zaku0101/mgr_board/hw/documents/mgr_board__Assembly.pdf

1 | 2 | 3 | 4 | 5 | 6

A

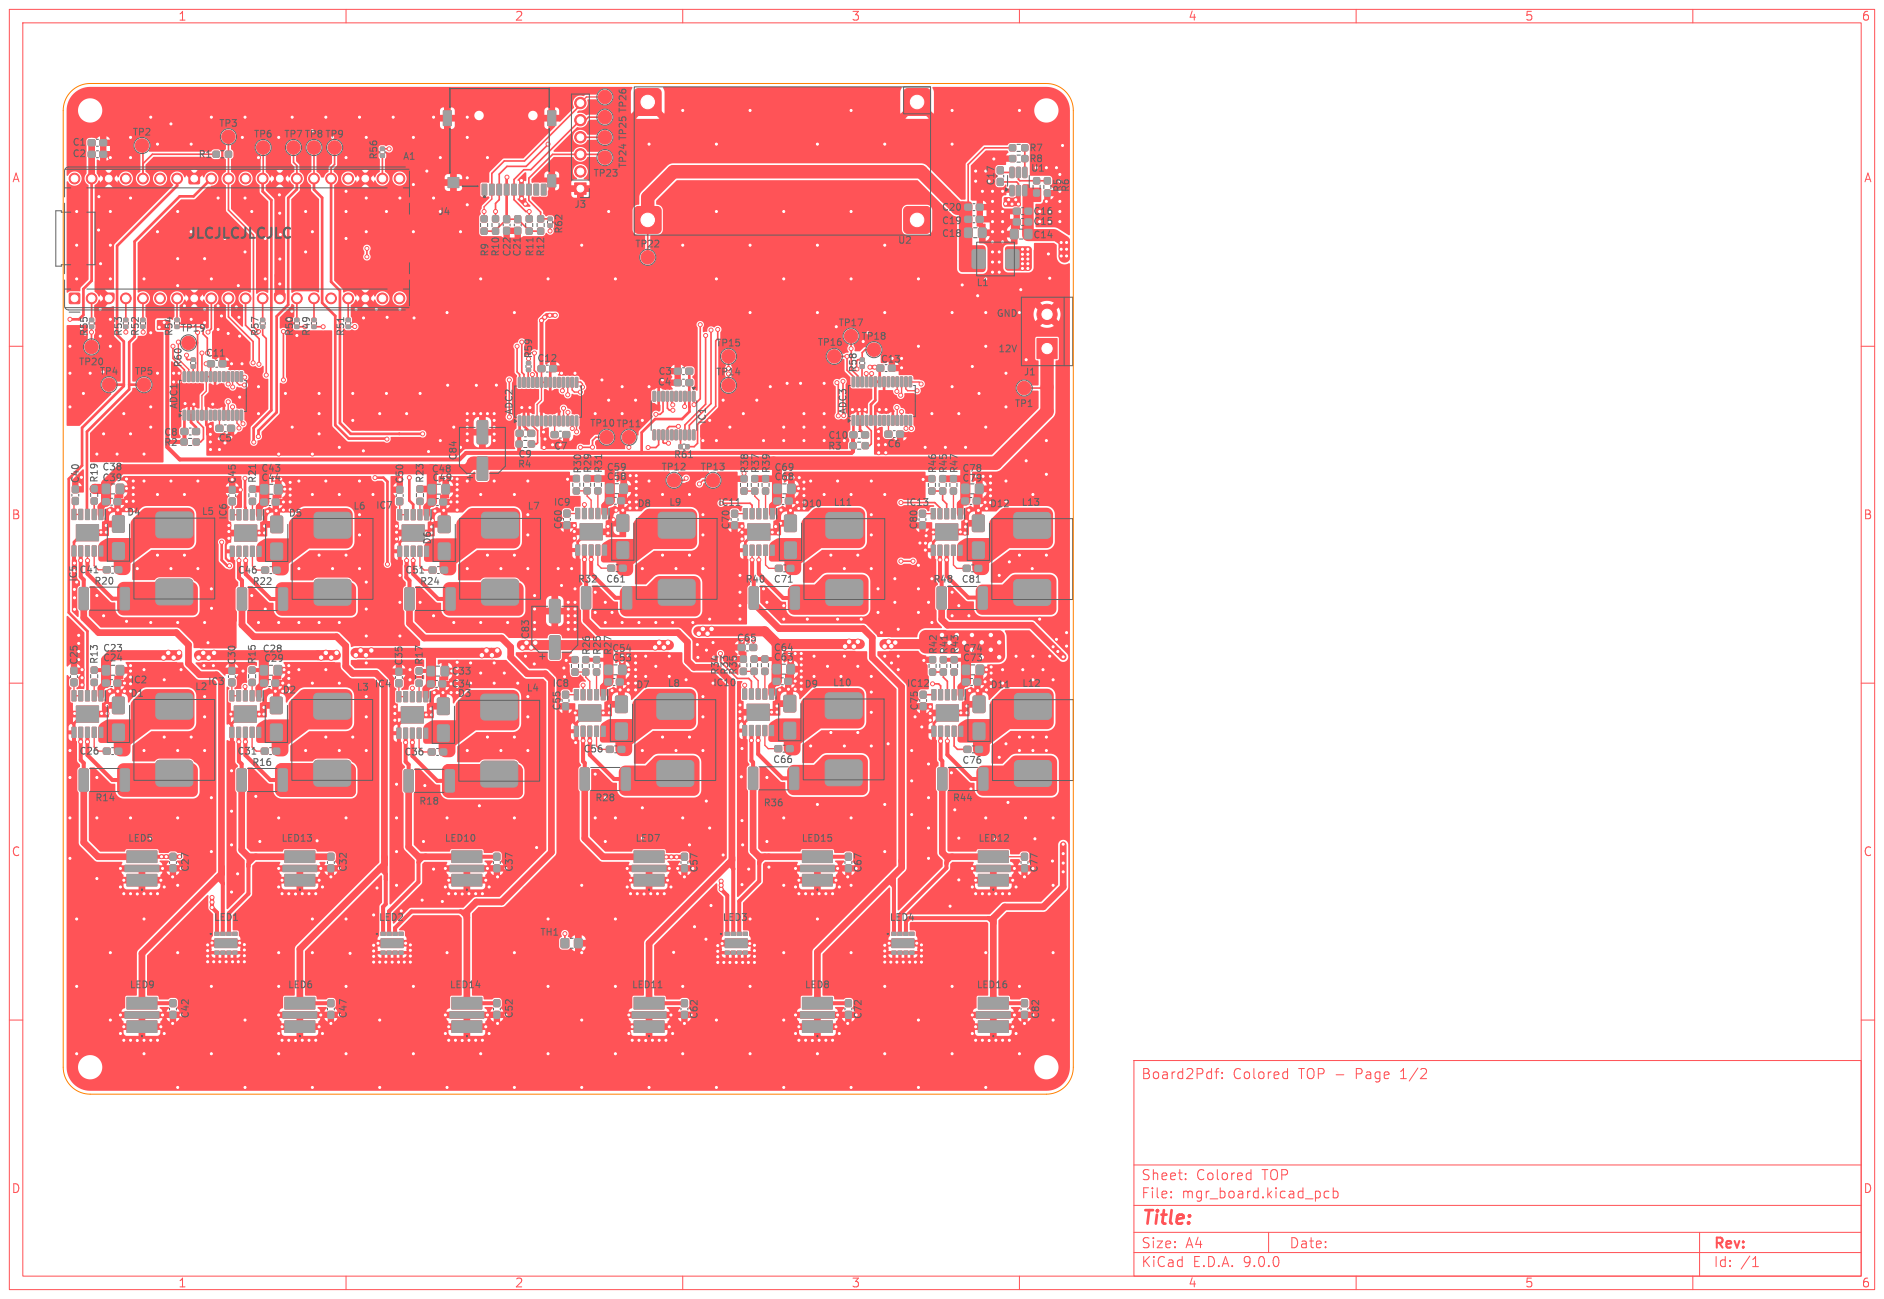
[picture p1: page 1]

1 | 2 | 3 | 4 | 5 | 6

A

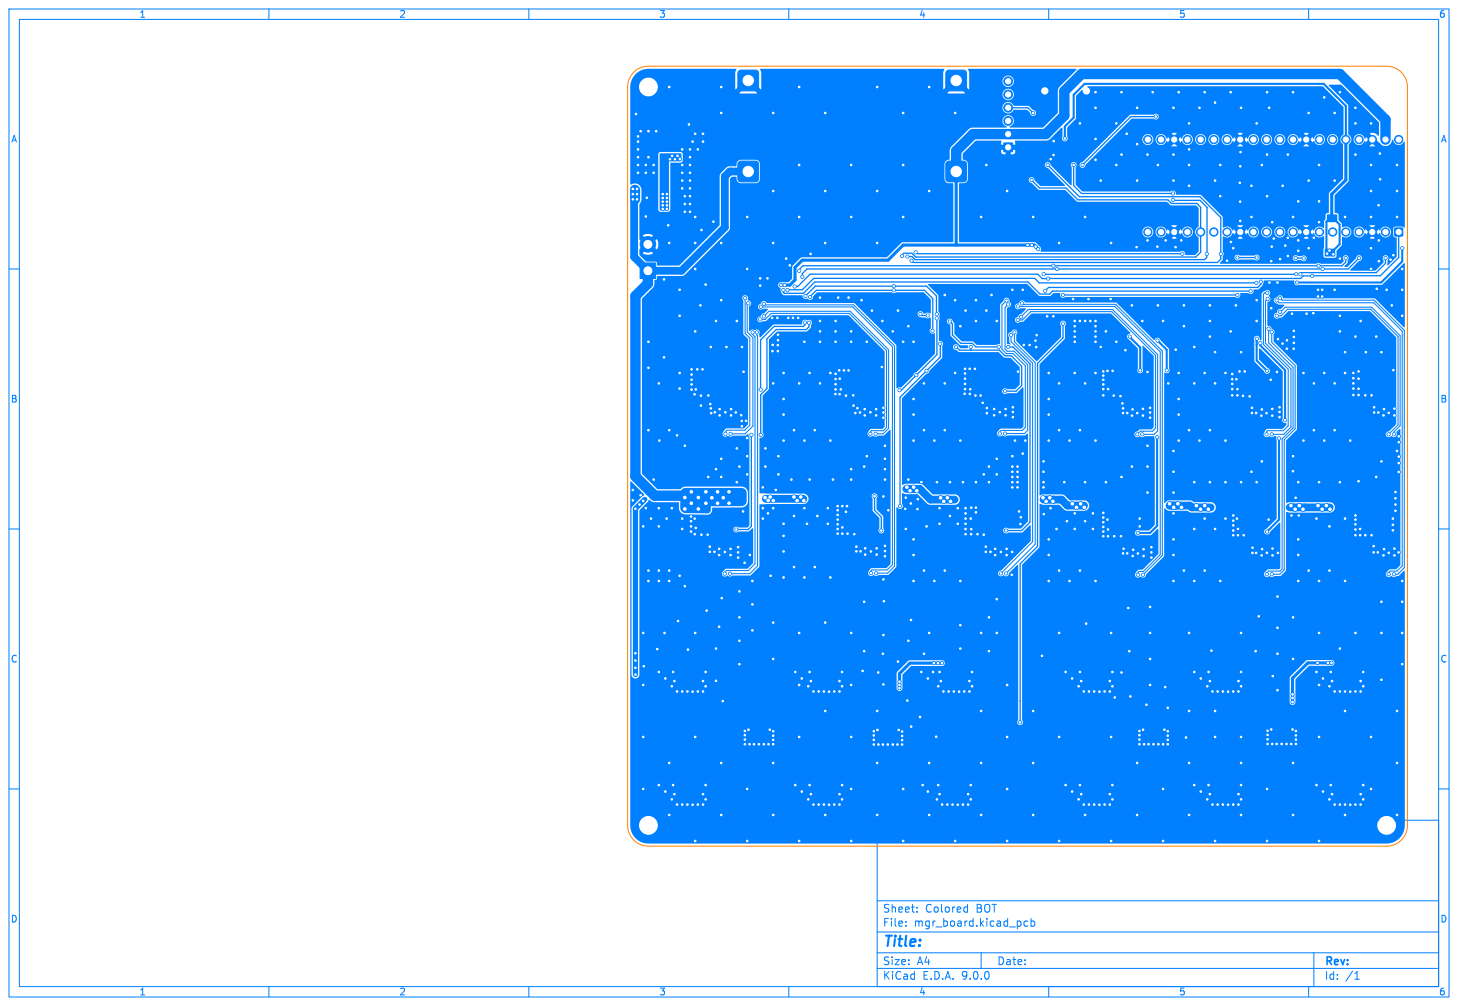
[picture p2: page 2]
D Date: KiCad; E.D.A. 9.0.0 Size: A4; Rev:; Id: /1 Title: File: mgr_board.kicad_pcb Sheet: Colored; BOT Board2Pdf:; Colored; BOT -; Page 2/2
