zaku0101/mgr_board/hw/documents/mgr_board.pdf

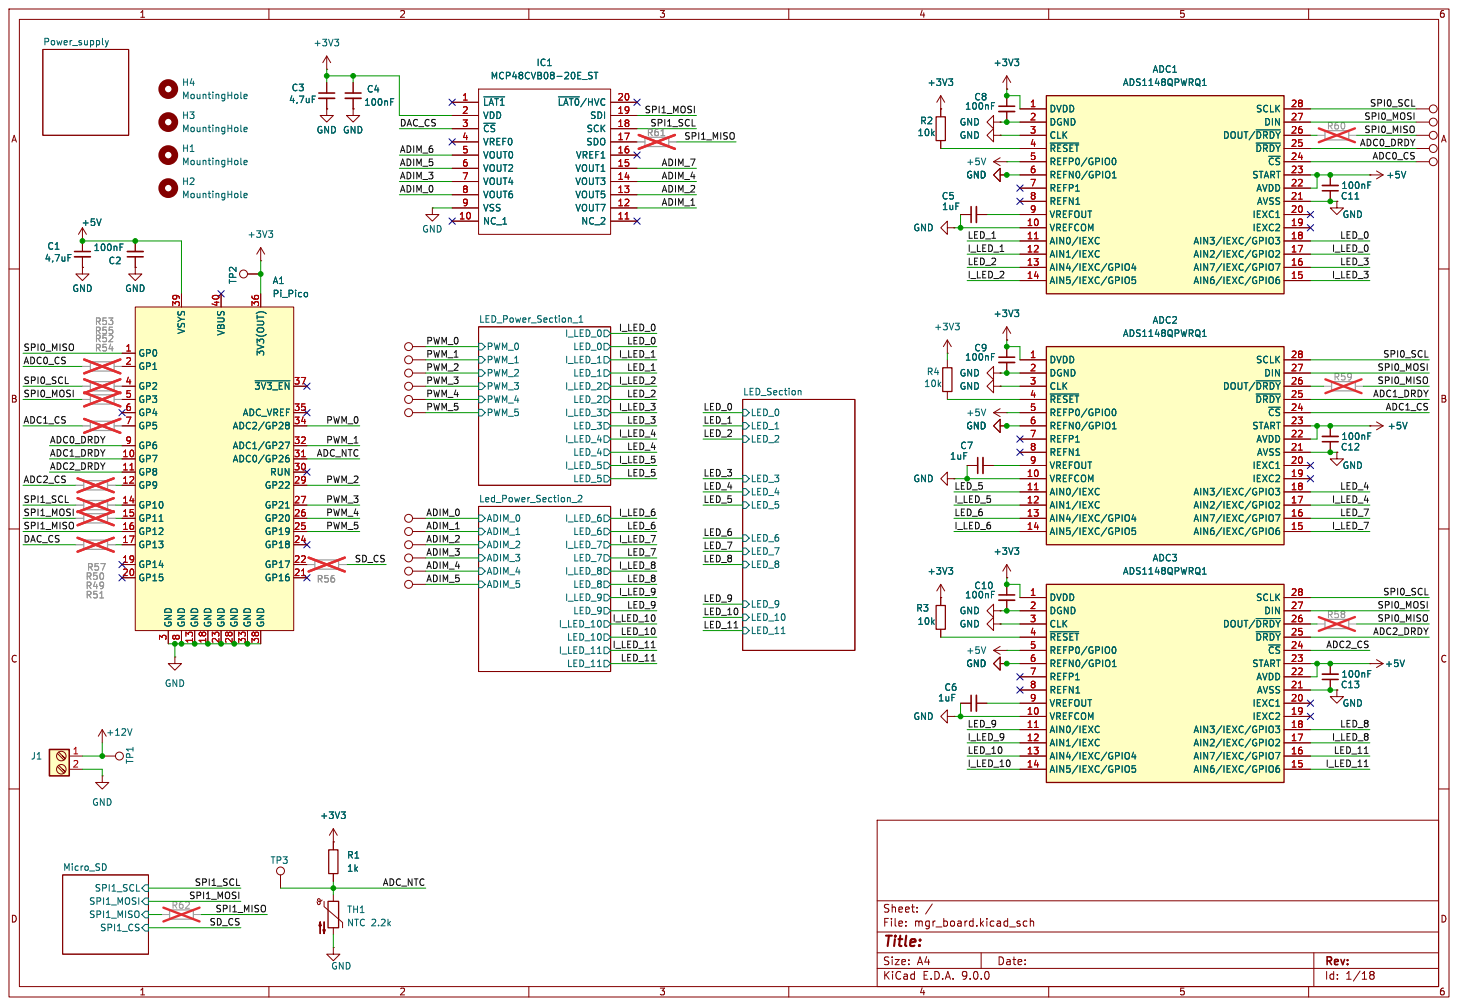
[picture p3: page 1]

8 GND 13 GND 18 VBUS 40 GND 23 GND 28 GND 33 3V3(OUT) 36 GND 38

SPI1_MOSI SPI1_MISO
Id: 1/18 Title: File: mgr_board.kicad_sch Sheet: / SPI1_CS

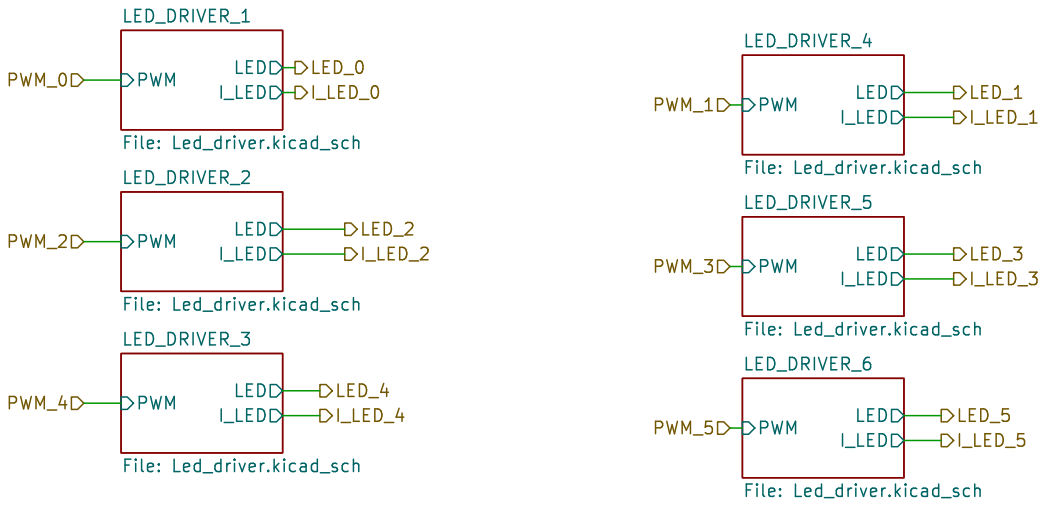
[picture p4: page 2]

Id: 2/18 Title: File: LED_Power_Section_1.kicad_sch Sheet: /LED_Power_Section_1/

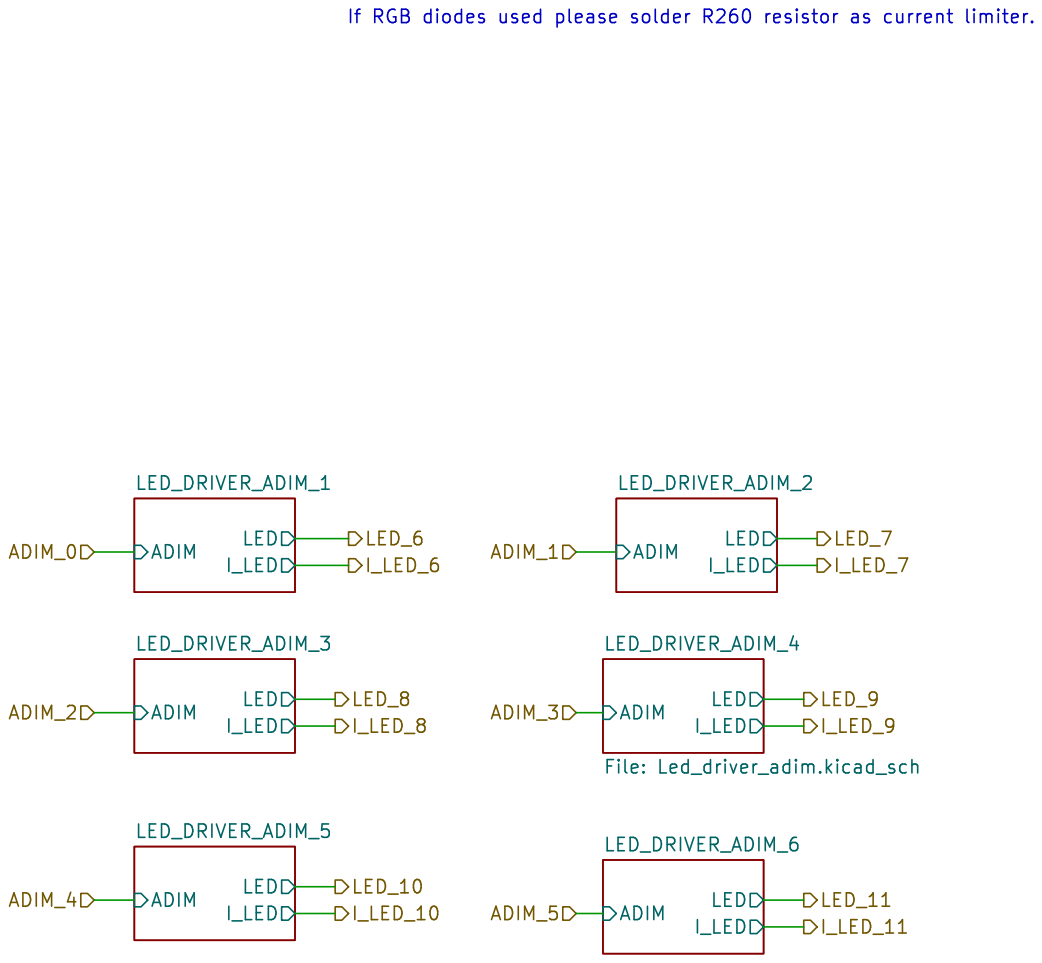
[picture p5: page 3]

Id: 3/18 Title: File: Led_Power_Section_2.kicad_sch Sheet: /Led_Power_Section_2/

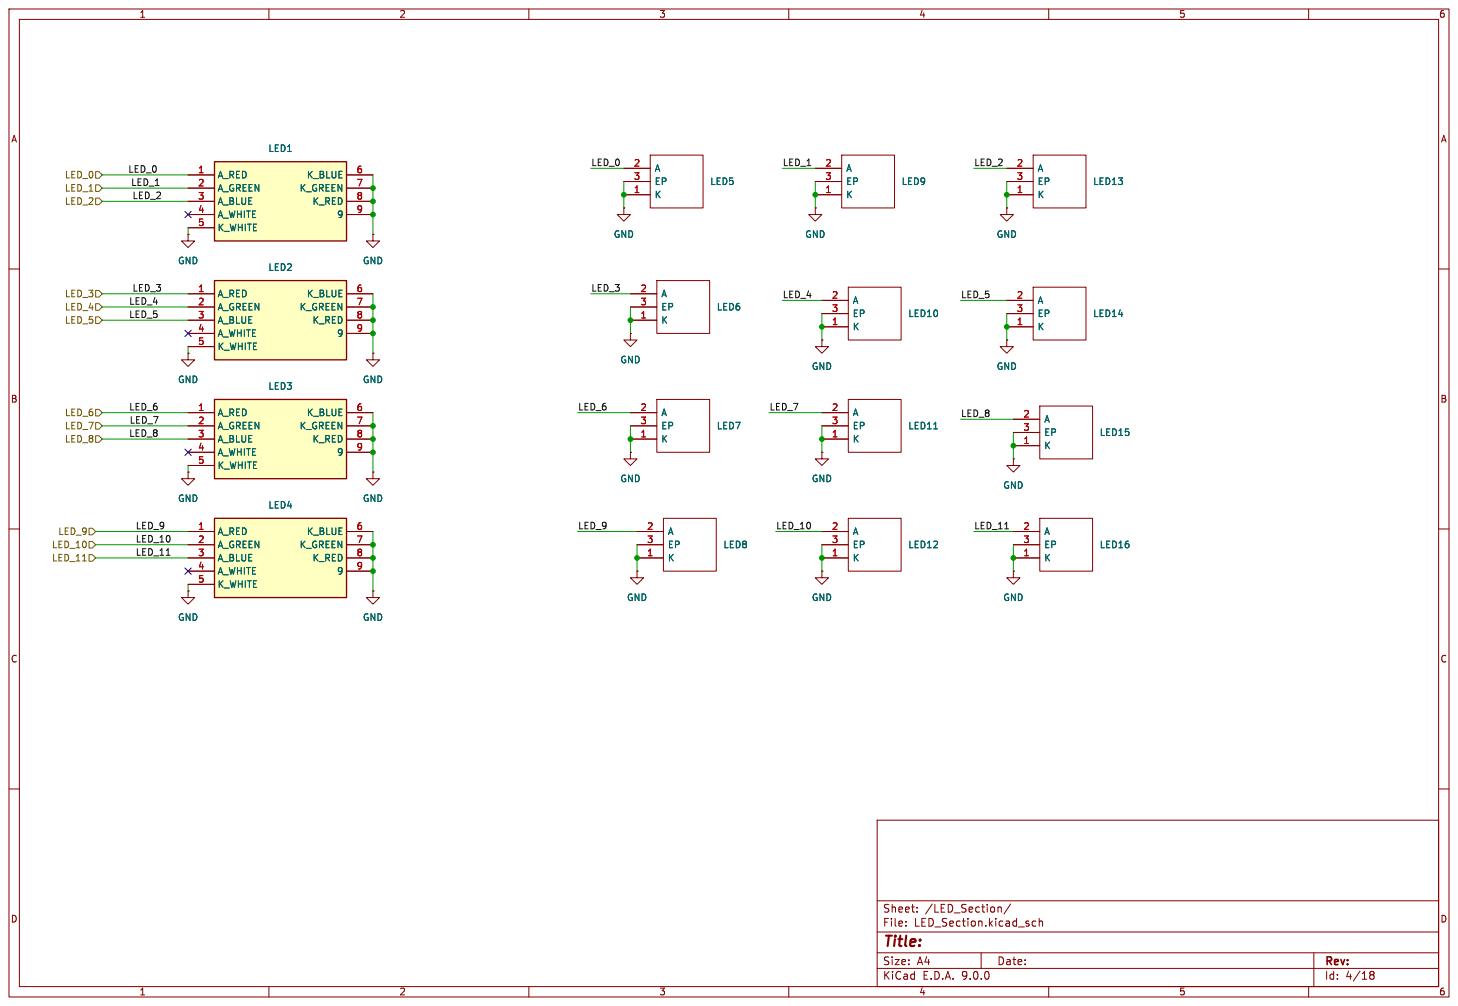
[picture p6: page 4]

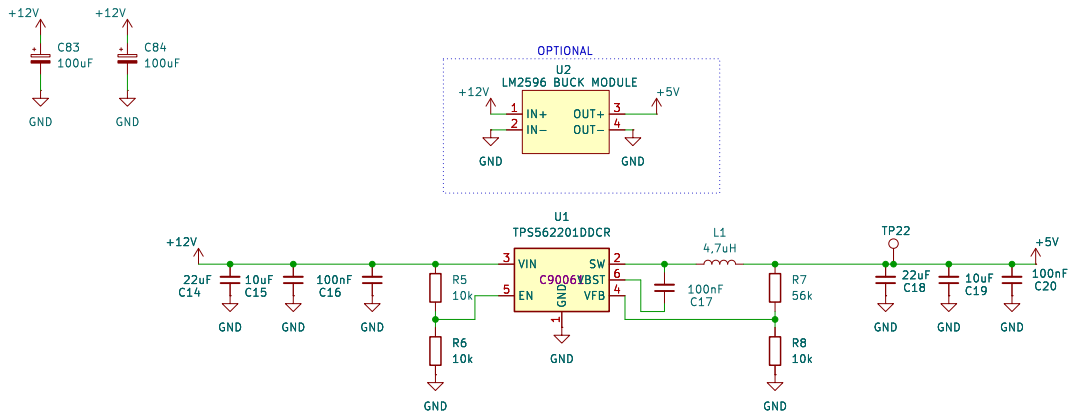
[picture p7: page 5]

Id: 5/18 Title: File: Power_supply.kicad_sch Sheet: /Power_supply/

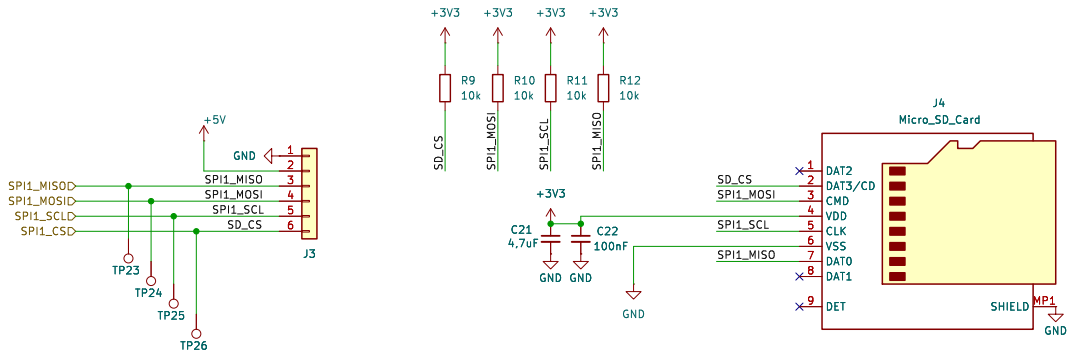
[picture p8: page 6]

Id: 6/18 Title: File: Micro_SD.kicad_sch Sheet: /Micro_SD/

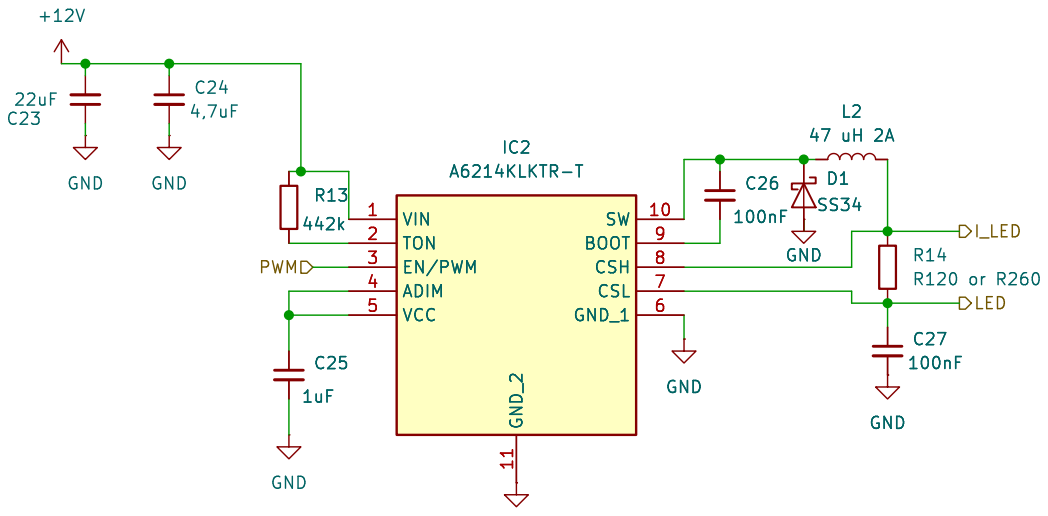
[picture p9: page 7]

Id: 7/18 Title: File: Led_driver.kicad_sch Sheet: /LED_Power_Section_1/LED_DRIVER_1/ C25

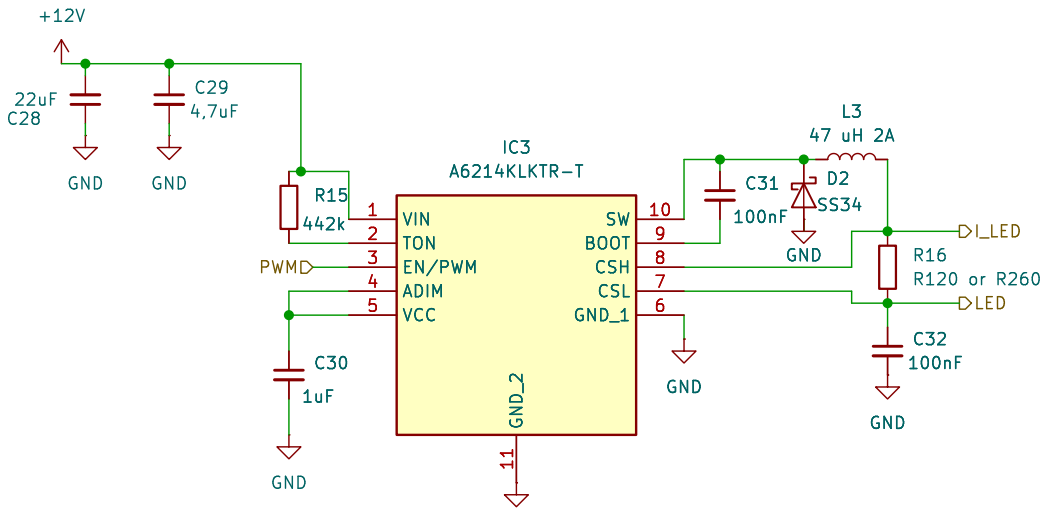
[picture p10: page 8]

Id: 8/18 Title: File: Led_driver.kicad_sch Sheet: /LED_Power_Section_1/LED_DRIVER_2/ C30

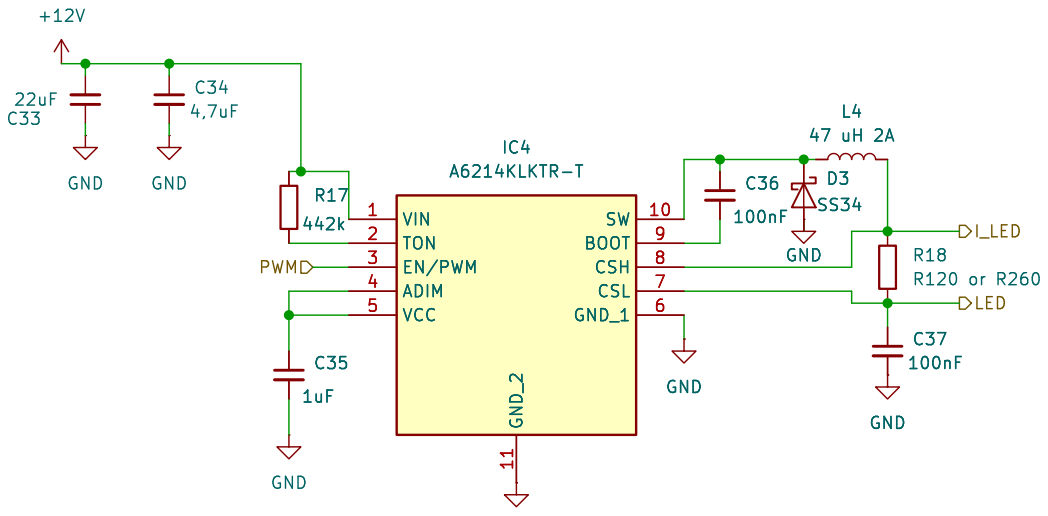
[picture p11: page 9]

Id: 9/18 Title: File: Led_driver.kicad_sch Sheet: /LED_Power_Section_1/LED_DRIVER_3/ C35

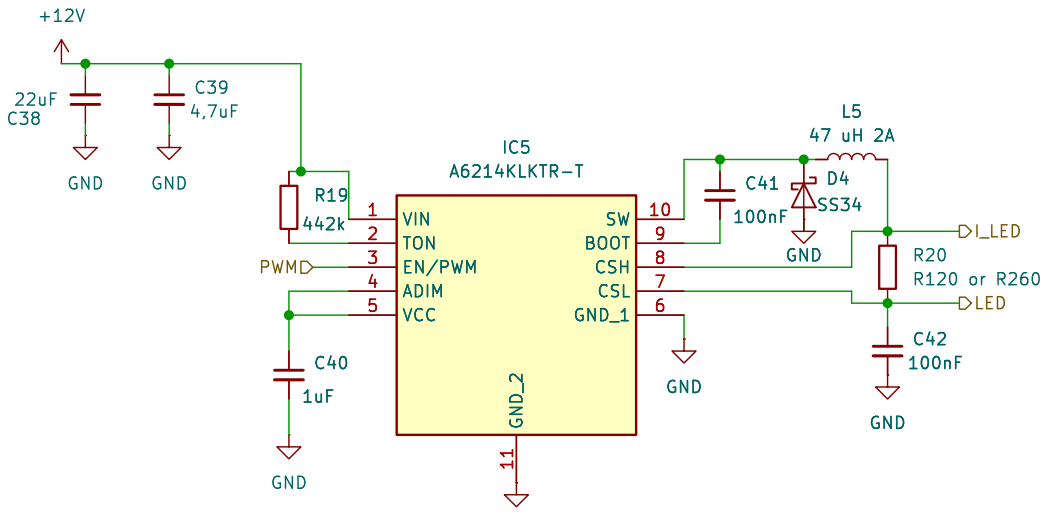
[picture p12: page 10]

Id: 10/18 Title: File: Led_driver.kicad_sch Sheet: /LED_Power_Section_1/LED_DRIVER_4/ C40

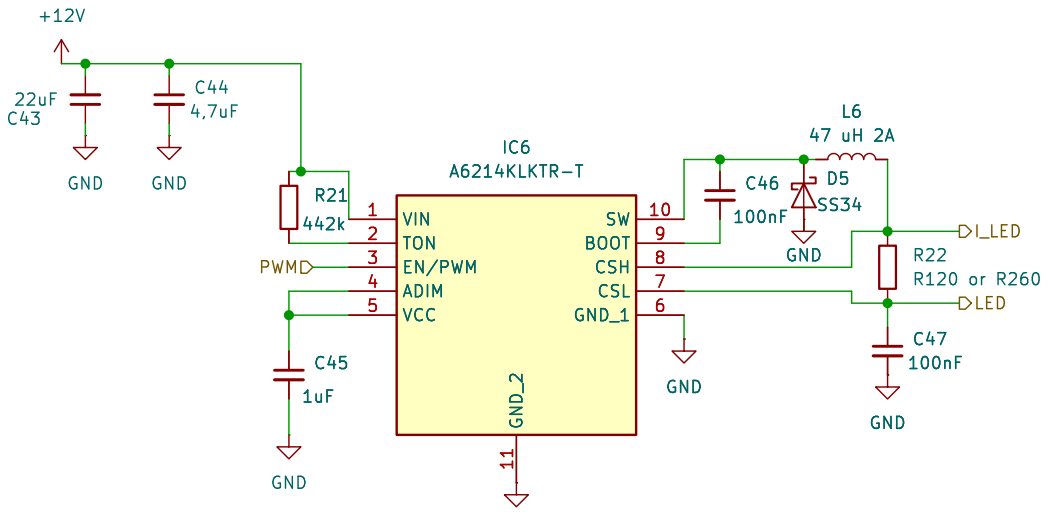
[picture p13: page 11]

Id: 11/18 Title: File: Led_driver.kicad_sch Sheet: /LED_Power_Section_1/LED_DRIVER_5/ C45

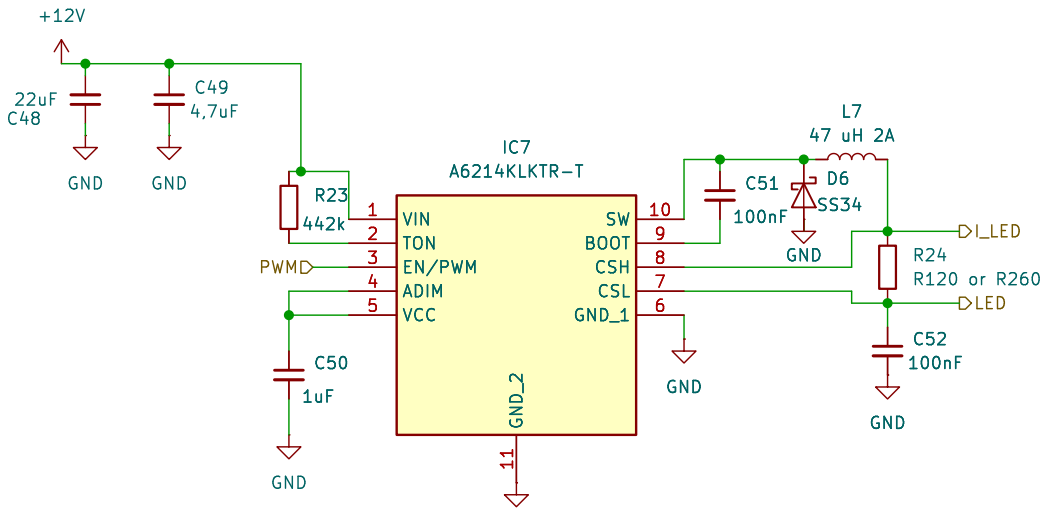
[picture p14: page 12]

Id: 12/18 Title: File: Led_driver.kicad_sch Sheet: /LED_Power_Section_1/LED_DRIVER_6/ C50

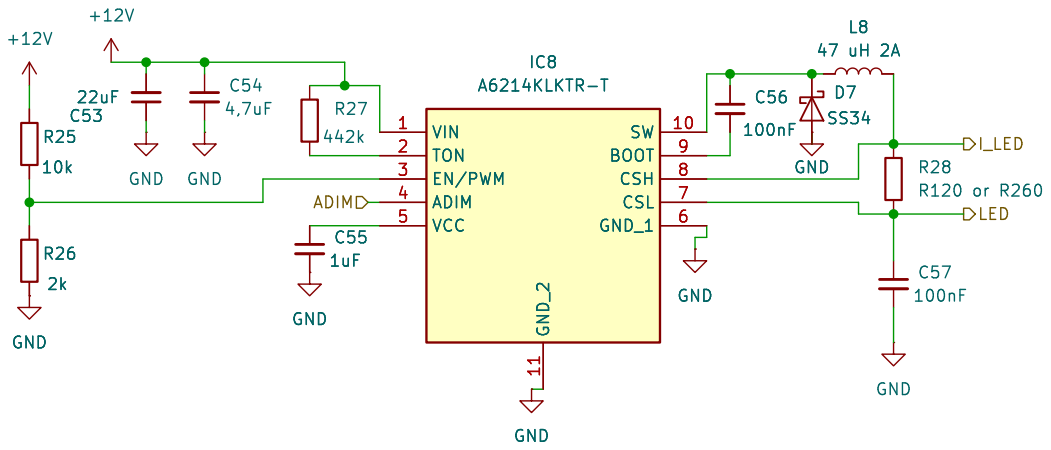
[picture p15: page 13]

Id: 13/18 Title: File: Led_driver_adim.kicad_sch Sheet: /Led_Power_Section_2/LED_DRIVER_ADIM_1/

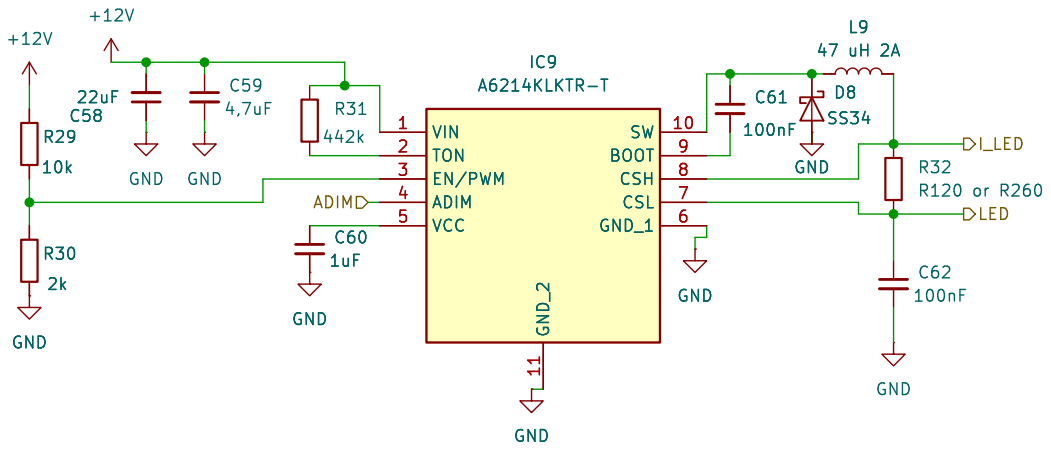
[picture p16: page 14]

Id: 14/18 Title: File: Led_driver_adim.kicad_sch Sheet: /Led_Power_Section_2/LED_DRIVER_ADIM_2/

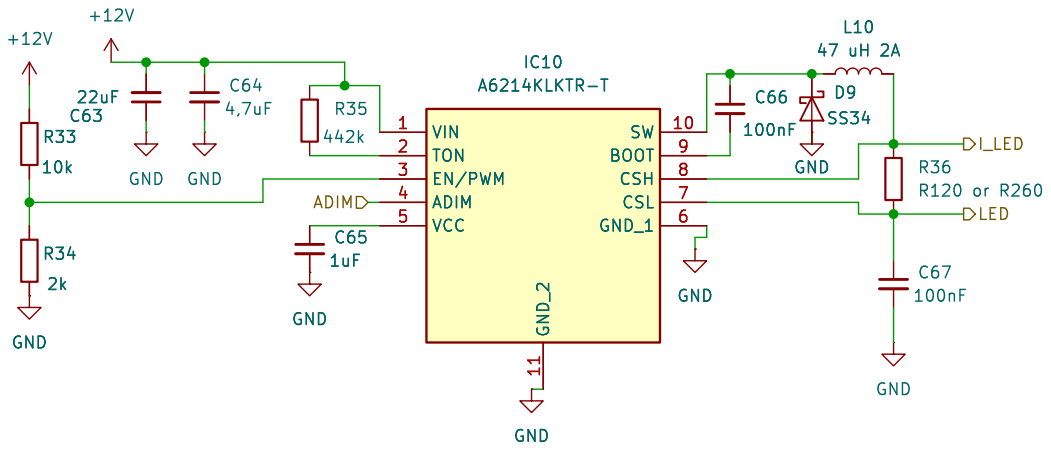
[picture p17: page 15]

Id: 15/18 Title: File: Led_driver_adim.kicad_sch Sheet: /Led_Power_Section_2/LED_DRIVER_ADIM_3/

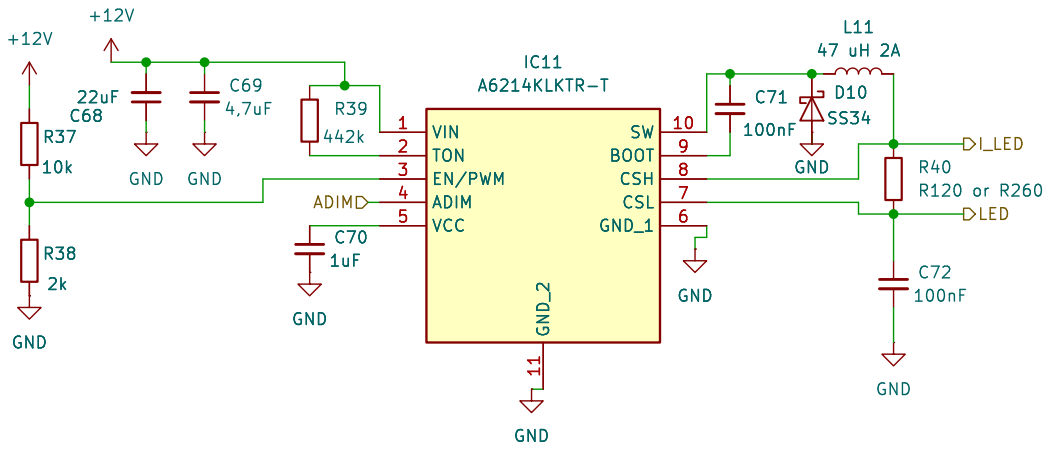
[picture p18: page 16]

Id: 16/18 Title: File: Led_driver_adim.kicad_sch Sheet: /Led_Power_Section_2/LED_DRIVER_ADIM_4/

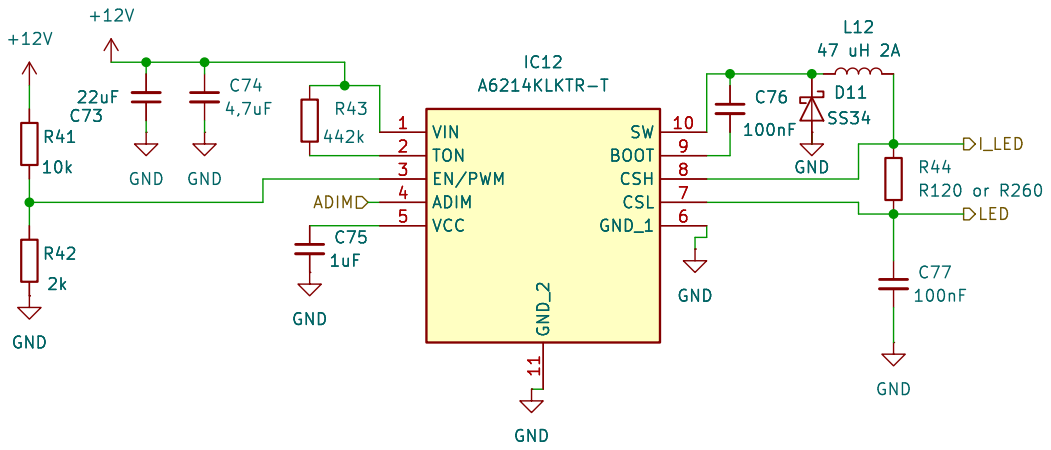
[picture p19: page 17]

Id: 17/18 Title: File: Led_driver_adim.kicad_sch Sheet: /Led_Power_Section_2/LED_DRIVER_ADIM_5/

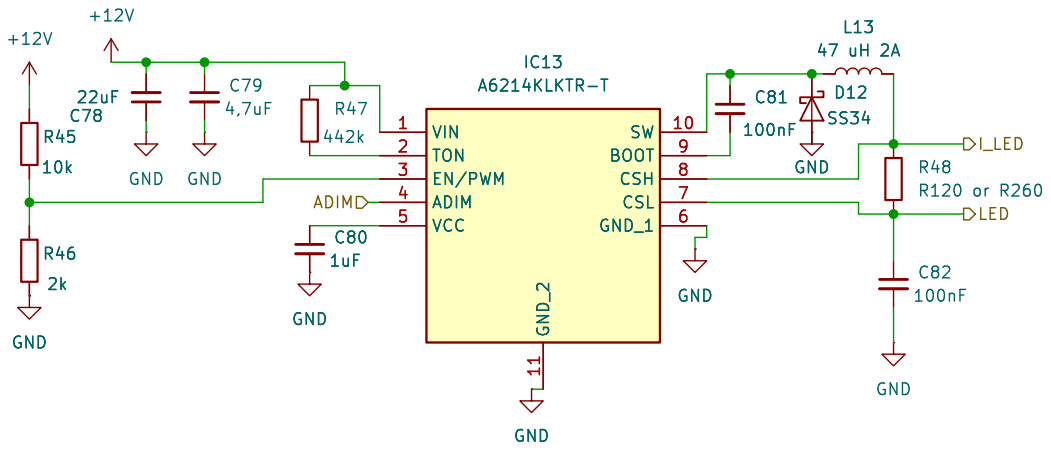
[picture p20: page 18]

Id: 18/18 Title: File: Led_driver_adim.kicad_sch Sheet: /Led_Power_Section_2/LED_DRIVER_ADIM_6/
