zaku0101/mgr_board/hw/mgr_board.kicad_pcb

## KiCad design hw/mgr_board.kicad_pcb (2025-04-14)

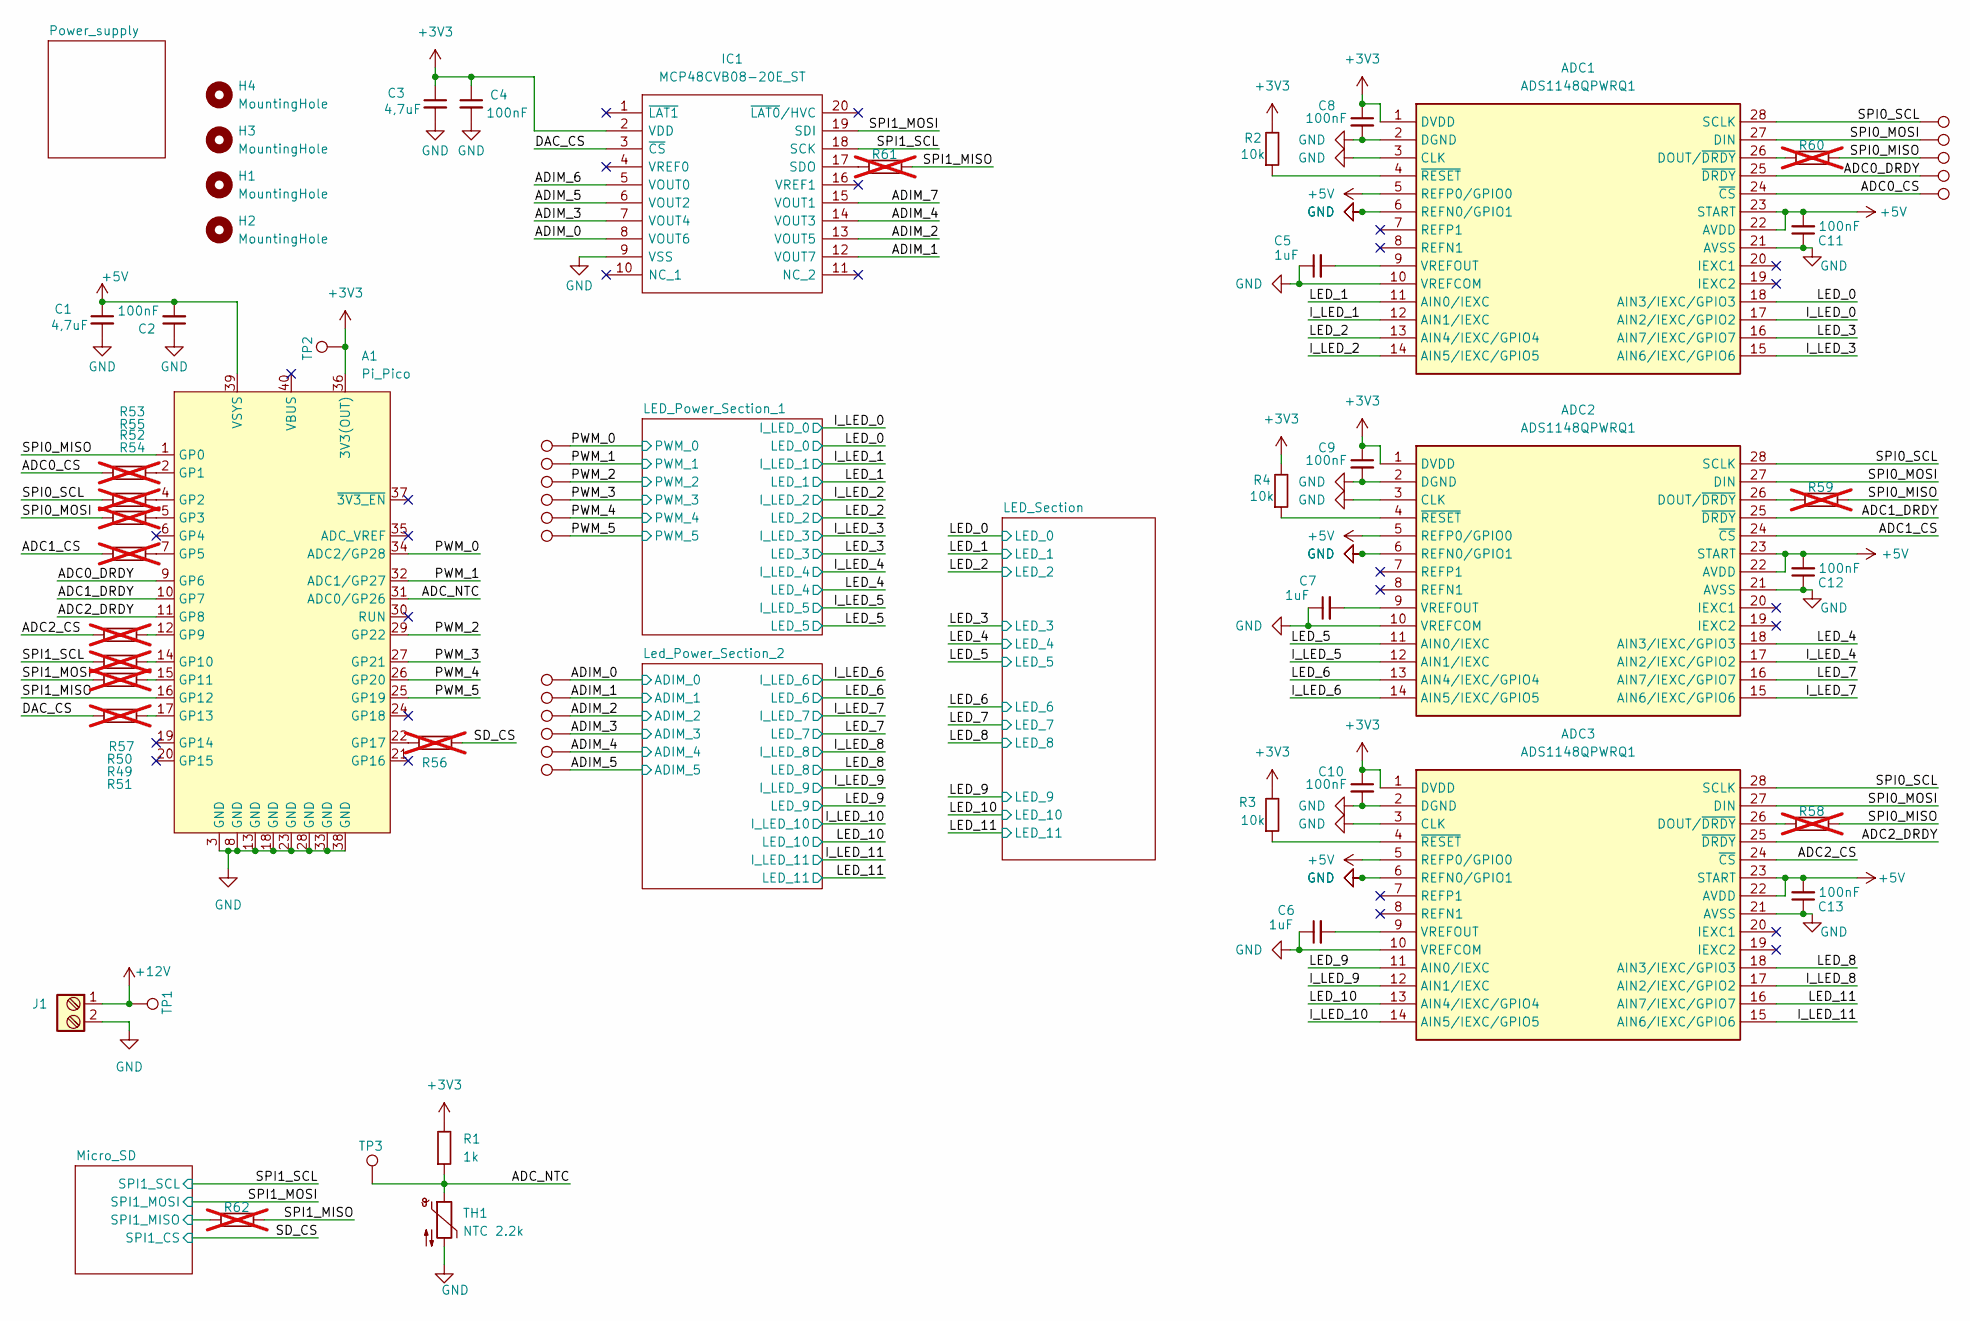
[picture p21: schematic mgr_board.kicad_sch]

Parts:
A1: Pi_Pico; RaspberryPi_Pico_Common_THT
ADC1, ADC2, ADC3: ADS1148QPWRQ1; TSSOP-28_4.4x9.7mm_P0.65mm; Mouser Part Number 595-ADS1148QPWRQ1
C1, C3: 4,7uF; C_0603_1608Metric_Pad1.08x0.95mm_HandSolder; LCSC C19666
C2, C4, C8, C9, C10, C11, C12, C13: 100nF; C_0603_1608Metric_Pad1.08x0.95mm_HandSolder; LCSC C14663
C5, C6, C7: 1uF; C_0603_1608Metric_Pad1.08x0.95mm_HandSolder; LCSC C15849
H1, H2, H3, H4: MountingHole; MountingHole_3.2mm_M3
IC1: MCP48CVB08-20E_ST; TSSOP-20_4.4x6.5mm_P0.65mm; Manufacturer_Part_Number MCP48CVB08-20E/ST
J1: Screw_Terminal_2_P5.00mm; TerminalBlock_bornier-2_P5.08mm
R1: 1k; R_0603_1608Metric_Pad0.98x0.95mm_HandSolder; LCSC C21190
R2, R3, R4: 10k; R_0603_1608Metric_Pad0.98x0.95mm_HandSolder; LCSC C25804
R49, R50, R51, R52, R53, R54, R55, R56, R57, R58, R59, R60, R61, R62: NMT; R_0402_1005Metric; not fitted
TH1: NTC 2.2k; R_0805_2012Metric_Pad1.20x1.40mm_HandSolder
TP1, TP2, TP3, TP4, TP5, TP6, TP7, TP8, TP9, TP10, TP11, TP12, TP13, TP14, TP15, TP16, TP17, TP18, TP19, TP20: TestPoint; TestPoint_Pad_D2.0mm

Connections:
+3V3: A1.36 (3V3(OUT)), ADC1.1 (DVDD), ADC2.1 (DVDD), ADC3.1 (DVDD), C3.1, C4.1, C8.1, C9.1, C10.1, IC1.2 (VDD), R1.2, R2.2, R3.2, R4.2, TP2.1; also elsewhere on the board
+5V: A1.39 (VSYS), ADC1.5 (REFP0/GPIO0), ADC1.22 (AVDD), ADC1.23 (START), ADC2.5 (REFP0/GPIO0), ADC2.22 (AVDD), ADC2.23 (START), ADC3.5 (REFP0/GPIO0), ADC3.22 (AVDD), ADC3.23 (START), C1.1, C2.2, C11.2, C12.2, C13.2; also elsewhere on the board
+12V: J1.1, TP1.1; also elsewhere on the board
/ADC0_CS: ADC1.24 (~CS), R55.2, TP20.1
/ADC0_DRDY: A1.9 (GP6), ADC1.25 (~DRDY), TP19.1
/ADC1_CS: ADC2.24 (~CS), R54.2
/ADC1_DRDY: A1.10 (GP7), ADC2.25 (~DRDY)
/ADC2_CS: ADC3.24 (~CS), R57.2
/ADC2_DRDY: A1.11 (GP8), ADC3.25 (~DRDY)
/ADC_NTC: A1.31 (ADC0/GP26), R1.1, TH1.1, TP3.1
/ADIM_0: IC1.8 (VOUT6), TP10.1; also elsewhere on the board
/ADIM_1: IC1.12 (VOUT7), TP11.1; also elsewhere on the board
/ADIM_2: IC1.13 (VOUT5), TP12.1; also elsewhere on the board
/ADIM_3: IC1.7 (VOUT4), TP13.1; also elsewhere on the board
/ADIM_4: IC1.14 (VOUT3), TP14.1; also elsewhere on the board
/ADIM_5: IC1.6 (VOUT2), TP15.1; also elsewhere on the board
/ADIM_6: IC1.5 (VOUT0)
/ADIM_7: IC1.15 (VOUT1)
/DAC_CS: IC1.3 (~CS), R51.2
/I_LED_0: ADC1.17 (AIN2/IEXC/GPIO2); also elsewhere on the board
/I_LED_1: ADC1.12 (AIN1/IEXC); also elsewhere on the board
/I_LED_2: ADC1.14 (AIN5/IEXC/GPIO5); also elsewhere on the board
/I_LED_3: ADC1.15 (AIN6/IEXC/GPIO6); also elsewhere on the board
/I_LED_4: ADC2.17 (AIN2/IEXC/GPIO2); also elsewhere on the board
/I_LED_5: ADC2.12 (AIN1/IEXC); also elsewhere on the board
/I_LED_6: ADC2.14 (AIN5/IEXC/GPIO5); also elsewhere on the board
/I_LED_7: ADC2.15 (AIN6/IEXC/GPIO6); also elsewhere on the board
/I_LED_8: ADC3.17 (AIN2/IEXC/GPIO2); also elsewhere on the board
/I_LED_9: ADC3.12 (AIN1/IEXC); also elsewhere on the board
/I_LED_10: ADC3.14 (AIN5/IEXC/GPIO5); also elsewhere on the board
/I_LED_11: ADC3.15 (AIN6/IEXC/GPIO6); also elsewhere on the board
/LED_0: ADC1.18 (AIN3/IEXC/GPIO3); also elsewhere on the board
/LED_1: ADC1.11 (AIN0/IEXC); also elsewhere on the board
/LED_2: ADC1.13 (AIN4/IEXC/GPIO4); also elsewhere on the board
/LED_3: ADC1.16 (AIN7/IEXC/GPIO7); also elsewhere on the board
/LED_4: ADC2.18 (AIN3/IEXC/GPIO3); also elsewhere on the board
/LED_5: ADC2.11 (AIN0/IEXC); also elsewhere on the board
/LED_6: ADC2.13 (AIN4/IEXC/GPIO4); also elsewhere on the board
/LED_7: ADC2.16 (AIN7/IEXC/GPIO7); also elsewhere on the board
/LED_8: ADC3.18 (AIN3/IEXC/GPIO3); also elsewhere on the board
/LED_9: ADC3.11 (AIN0/IEXC); also elsewhere on the board
/LED_10: ADC3.13 (AIN4/IEXC/GPIO4); also elsewhere on the board
/LED_11: ADC3.16 (AIN7/IEXC/GPIO7); also elsewhere on the board
/Micro_SD/SPI1_MISO: R62.2; also elsewhere on the board
/PWM_0: A1.34 (ADC2/GP28), TP4.1; also elsewhere on the board
/PWM_1: A1.32 (ADC1/GP27), TP5.1; also elsewhere on the board
/PWM_2: A1.29 (GP22), TP6.1; also elsewhere on the board
/PWM_3: A1.27 (GP21), TP7.1; also elsewhere on the board
/PWM_4: A1.26 (GP20), TP8.1; also elsewhere on the board
/PWM_5: A1.25 (GP19), TP9.1; also elsewhere on the board
/SD_CS: R56.1; also elsewhere on the board
/SPI0_MISO: A1.1 (GP0), R58.1, R59.1, R60.1, TP18.1
/SPI0_MOSI: ADC1.27 (DIN), ADC2.27 (DIN), ADC3.27 (DIN), R52.2, TP17.1
/SPI0_SCL: ADC1.28 (SCLK), ADC2.28 (SCLK), ADC3.28 (SCLK), R53.2, TP16.1
/SPI1_MISO: A1.16 (GP12), R61.1, R62.1
/SPI1_MOSI: IC1.19 (SDI), R49.2; also elsewhere on the board
/SPI1_SCL: IC1.18 (SCK), R50.2; also elsewhere on the board
GND: A1.3 (GND), A1.8 (GND), A1.13 (GND), A1.18 (GND), A1.23 (GND), A1.28 (GND), A1.33 (GND), A1.38 (GND), ADC1.2 (DGND), ADC1.3 (CLK), ADC1.6 (REFN0/GPIO1), ADC1.10 (VREFCOM), ADC1.21 (AVSS), ADC2.2 (DGND), ADC2.3 (CLK), ADC2.6 (REFN0/GPIO1), ADC2.10 (VREFCOM), ADC2.21 (AVSS), ADC3.2 (DGND), ADC3.3 (CLK), ADC3.6 (REFN0/GPIO1), ADC3.10 (VREFCOM), ADC3.21 (AVSS), C1.2, C2.1, C3.2, C4.2, C5.1, C6.1, C7.1, C8.2, C9.2, C10.2, C11.1, C12.1, C13.1, IC1.9 (VSS), J1.2, TH1.2; also elsewhere on the board
unnamed: A1.2 (GP1), R55.1
unnamed: A1.4 (GP2), R53.1
unnamed: A1.5 (GP3), R52.1
unnamed: A1.7 (GP5), R54.1
unnamed: A1.12 (GP9), R57.1
unnamed: A1.14 (GP10), R50.1
unnamed: A1.15 (GP11), R49.1
unnamed: A1.17 (GP13), R51.1
unnamed: A1.22 (GP17), R56.2
unnamed: ADC1.26 (DOUT/~DRDY), R60.2
unnamed: ADC1.9 (VREFOUT), C5.2
unnamed: ADC1.4 (~RESET), R2.1
unnamed: ADC2.26 (DOUT/~DRDY), R59.2
unnamed: ADC2.9 (VREFOUT), C7.2
unnamed: ADC2.4 (~RESET), R4.1
unnamed: ADC3.26 (DOUT/~DRDY), R58.2
unnamed: ADC3.9 (VREFOUT), C6.2
unnamed: ADC3.4 (~RESET), R3.1
unnamed: IC1.17 (SDO), R61.2

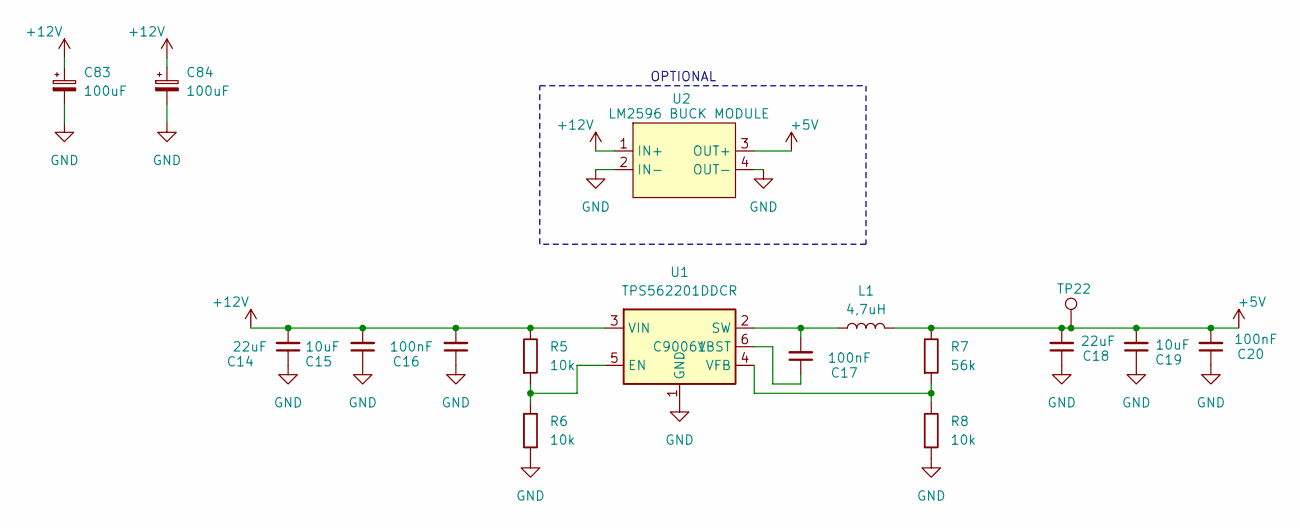
[picture p22: schematic Power_supply.kicad_sch]

Parts:
C14, C18: 22uF; C_0805_2012Metric_Pad1.18x1.45mm_HandSolder; LCSC C96446
C15, C19: 10uF; C_0603_1608Metric_Pad1.08x0.95mm_HandSolder; LCSC C45783
C16, C17, C20: 100nF; C_0603_1608Metric_Pad1.08x0.95mm_HandSolder; LCSC C14663
C83, C84: 100uF; CP_Elec_6.3x7.7
L1: 4,7uH; HPIO530-4R7; LCSC C408410
R5, R6, R8: 10k; R_0603_1608Metric_Pad0.98x0.95mm_HandSolder; LCSC C25804
R7: 56k; R_0603_1608Metric_Pad0.98x0.95mm_HandSolder; LCSC C23206
TP22: TestPoint; TestPoint_Pad_D2.0mm
U1: TPS562201DDCR; SOT-23-6_Handsoldering; LCSC C90061
U2: LM2596 BUCK MODULE; LM2596 DC-DC module

Connections:
+5V: C18.2, C19.2, C20.2, L1.2, R7.2, TP22.1, U2.3 (OUT+); also elsewhere on the board
+12V: C14.2, C15.2, C16.2, C83.1, C84.1, R5.2, U1.3 (VIN), U2.1 (IN+); also elsewhere on the board
GND: C14.1, C15.1, C16.1, C18.1, C19.1, C20.1, C83.2, C84.2, R6.1, R8.1, U1.1 (GND), U2.2 (IN-), U2.4 (OUT-); also elsewhere on the board
unnamed: R5.1, R6.2, U1.5 (EN)
unnamed: C17.2, L1.1, U1.2 (SW)
unnamed: C17.1, U1.6 (VBST)
unnamed: R7.1, R8.2, U1.4 (VFB)

Notes on the sheet:
OPTIONAL

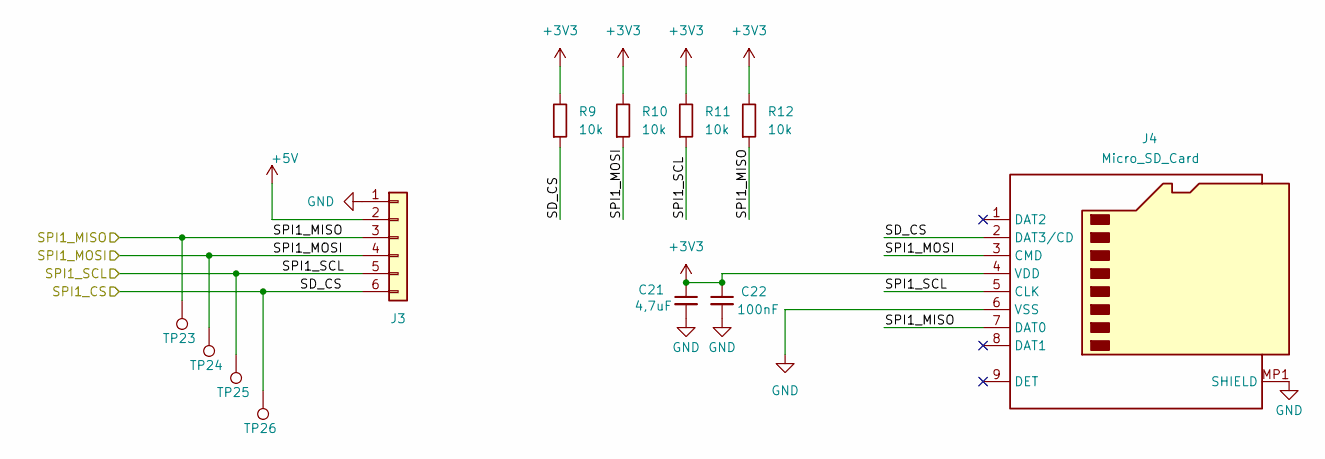
[picture p23: schematic Micro_SD.kicad_sch]

Parts:
C21: 4,7uF; C_0603_1608Metric_Pad1.08x0.95mm_HandSolder; LCSC C19666
C22: 100nF; C_0603_1608Metric_Pad1.08x0.95mm_HandSolder; LCSC C14663
J3: SD Card SPI Module; PinHeader_1x06_P2.54mm_Vertical; Part Number 1-0601FBV0T
J4: Micro_SD_Card; MCSPQ08ASGTR
R9, R10, R11, R12: 10k; R_0603_1608Metric_Pad0.98x0.95mm_HandSolder; LCSC C25804
TP23, TP24, TP25, TP26: TestPoint; TestPoint_Pad_D2.0mm

Connections:
+3V3: C21.1, C22.1, J4.4 (VDD), R9.2, R10.2, R11.2, R12.2; also elsewhere on the board
+5V: J3.2; also elsewhere on the board
/Micro_SD/SPI1_MISO: J3.3, J4.7 (DAT0), R12.1, TP23.1; also elsewhere on the board
/SD_CS: J3.6, J4.2 (DAT3/CD), R9.1, TP26.1; also elsewhere on the board
/SPI1_MOSI: J3.4, J4.3 (CMD), R10.1, TP24.1; also elsewhere on the board
/SPI1_SCL: J3.5, J4.5 (CLK), R11.1, TP25.1; also elsewhere on the board
GND: C21.2, C22.2, J3.1, J4.6 (VSS), J4.MP1 (SHIELD), J4.MP2 (SHIELD), J4.MP3 (SHIELD), J4.MP4 (SHIELD); also elsewhere on the board

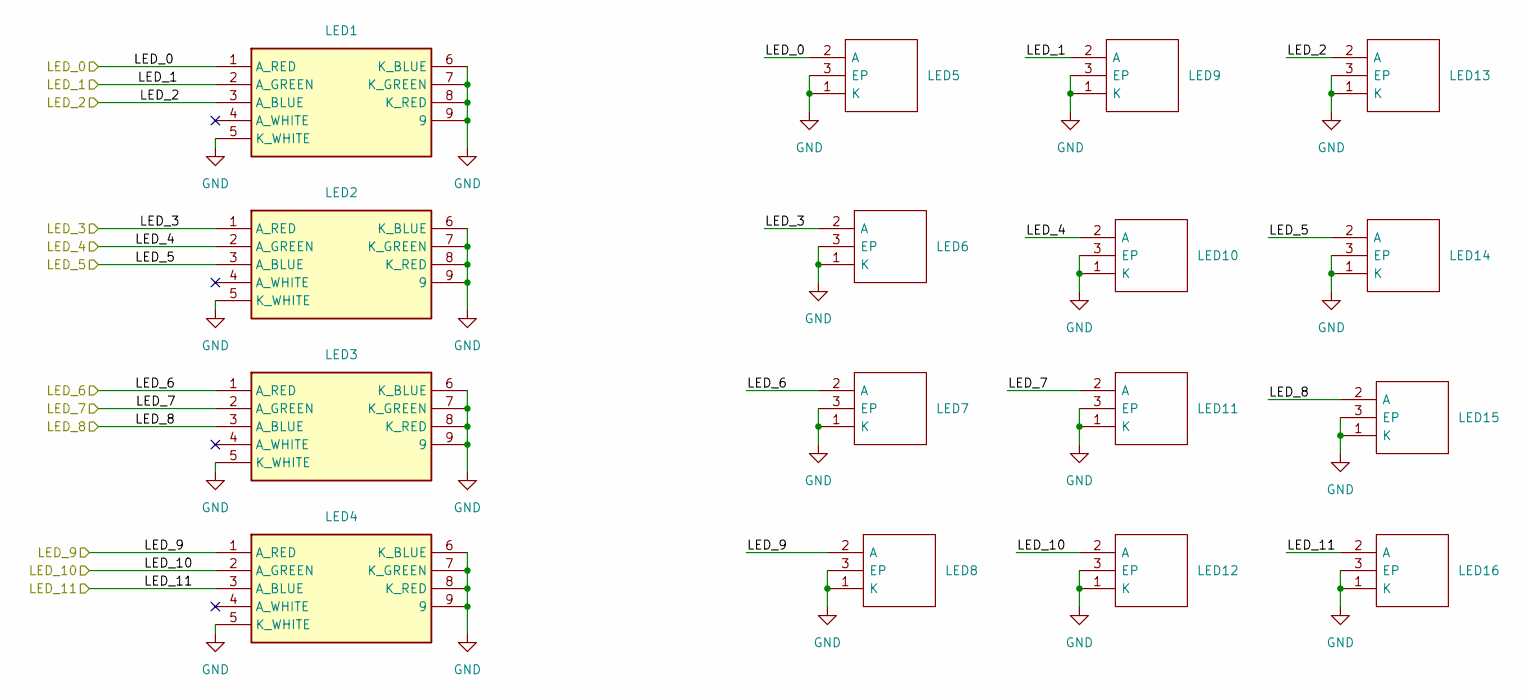
[picture p24: schematic LED_Section.kicad_sch]

Parts:
LED1, LED2, LED3, LED4: XPLDCL-00-0000-0000HC6AAAE7; XPLDCL; Mouser Part Number 941-XPLDCL00HC6AAAE7
LED5, LED6, LED7, LED8, LED9, LED10, LED11, LED12, LED13, LED14, LED15, LED16: JR5050CWT-E-B50EB0000-N0000001; JR5050CWT; Mouser Part Number 941-JR5050CWTEB50EBN

Connections:
/LED_0: LED1.1 (A_RED), LED5.2 (A); also elsewhere on the board
/LED_1: LED1.2 (A_GREEN), LED9.2 (A); also elsewhere on the board
/LED_2: LED1.3 (A_BLUE), LED13.2 (A); also elsewhere on the board
/LED_3: LED2.1 (A_RED), LED6.2 (A); also elsewhere on the board
/LED_4: LED2.2 (A_GREEN), LED10.2 (A); also elsewhere on the board
/LED_5: LED2.3 (A_BLUE), LED14.2 (A); also elsewhere on the board
/LED_6: LED3.1 (A_RED), LED7.2 (A); also elsewhere on the board
/LED_7: LED3.2 (A_GREEN), LED11.2 (A); also elsewhere on the board
/LED_8: LED3.3 (A_BLUE), LED15.2 (A); also elsewhere on the board
/LED_9: LED4.1 (A_RED), LED8.2 (A); also elsewhere on the board
/LED_10: LED4.2 (A_GREEN), LED12.2 (A); also elsewhere on the board
/LED_11: LED4.3 (A_BLUE), LED16.2 (A); also elsewhere on the board
GND: LED1.5 (K_WHITE), LED1.6 (K_BLUE), LED1.7 (K_GREEN), LED1.8 (K_RED), LED1.9, LED2.5 (K_WHITE), LED2.6 (K_BLUE), LED2.7 (K_GREEN), LED2.8 (K_RED), LED2.9, LED3.5 (K_WHITE), LED3.6 (K_BLUE), LED3.7 (K_GREEN), LED3.8 (K_RED), LED3.9, LED4.5 (K_WHITE), LED4.6 (K_BLUE), LED4.7 (K_GREEN), LED4.8 (K_RED), LED4.9, LED5.1 (K), LED5.3 (EP), LED6.1 (K), LED6.3 (EP), LED7.1 (K), LED7.3 (EP), LED8.1 (K), LED8.3 (EP), LED9.1 (K), LED9.3 (EP), LED10.1 (K), LED10.3 (EP), LED11.1 (K), LED11.3 (EP), LED12.1 (K), LED12.3 (EP), LED13.1 (K), LED13.3 (EP), LED14.1 (K), LED14.3 (EP), LED15.1 (K), LED15.3 (EP), LED16.1 (K), LED16.3 (EP); also elsewhere on the board

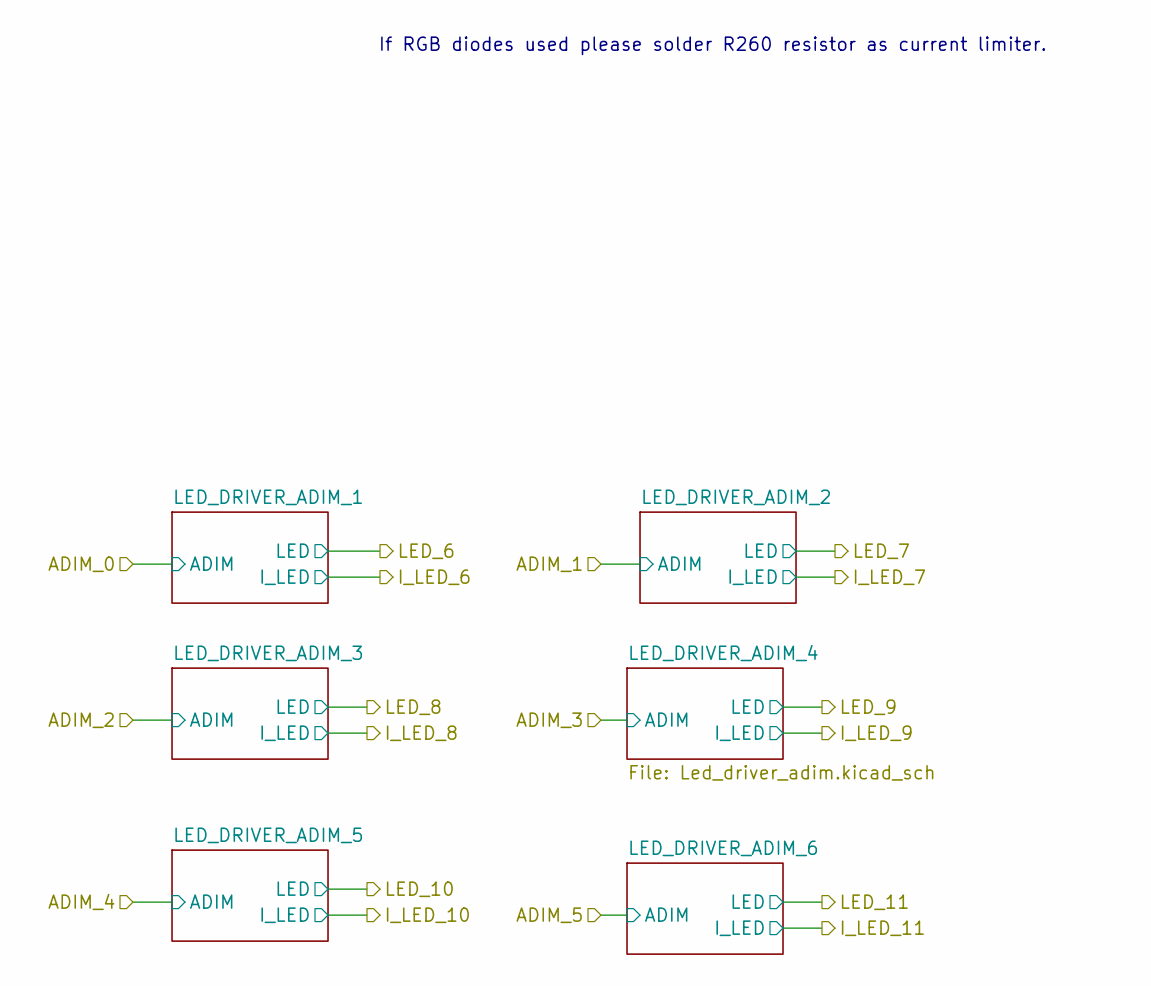
[picture p25: schematic Led_Power_Section_2.kicad_sch]

Notes on the sheet:
If RGB diodes used please solder R260 resistor as current limiter.

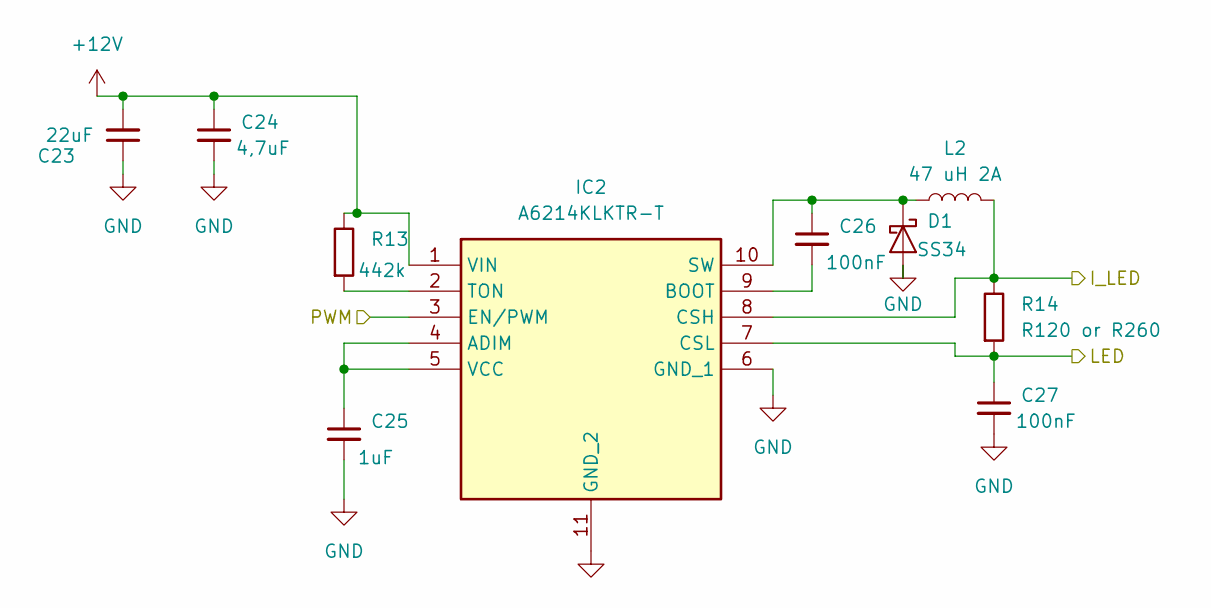
[picture p26: schematic Led_driver.kicad_sch]

Parts:
C23: 22uF; C_0805_2012Metric_Pad1.18x1.45mm_HandSolder; LCSC C96446
C24: 4,7uF; C_0603_1608Metric_Pad1.08x0.95mm_HandSolder; LCSC C19666
C25: 1uF; C_0603_1608Metric_Pad1.08x0.95mm_HandSolder; LCSC C15849
C26, C27: 100nF; C_0603_1608Metric_Pad1.08x0.95mm_HandSolder; LCSC C14663
D1: SS34; D_SMA; Part Number B140-E3/5AT; JLCPCB ID C15759
IC2: A6214KLKTR-T; SOP100P600X165-11N; Manufacturer_Part_Number A6214KLKTR-T; LCSC C146400
L2: 47 uH 2A; DR125-470-R; LCSC C5127262
R13: 442k; R_0603_1608Metric_Pad0.98x0.95mm_HandSolder; LCSC C23175
R14: R120 or R260; R_2512_6332Metric_Pad1.40x3.35mm_HandSolder

Connections:
+12V: C23.2, C24.1, IC2.1 (VIN), R13.2; also elsewhere on the board
/I_LED_0: IC2.8 (CSH), L2.2, R14.2; also elsewhere on the board
/LED_0: C27.1, IC2.7 (CSL), R14.1; also elsewhere on the board
/PWM_0: IC2.3 (EN/PWM); also elsewhere on the board
GND: C23.1, C24.2, C25.2, C27.2, D1.2 (A), IC2.6 (GND_1), IC2.11 (GND_2); also elsewhere on the board
unnamed: C26.1, D1.1 (K), IC2.10 (SW), L2.1
unnamed: C25.1, IC2.4 (ADIM), IC2.5 (VCC)
unnamed: C26.2, IC2.9 (BOOT)
unnamed: IC2.2 (TON), R13.1

Parts of its further copies:
C28, C33, C38, C43, C48: 22uF; C_0805_2012Metric_Pad1.18x1.45mm_HandSolder; LCSC C96446
C29, C34, C39, C44, C49: 4,7uF; C_0603_1608Metric_Pad1.08x0.95mm_HandSolder; LCSC C19666
C30, C35, C40, C45, C50: 1uF; C_0603_1608Metric_Pad1.08x0.95mm_HandSolder; LCSC C15849
C31, C32, C36, C37, C41, C42, C46, C47, C51, C52: 100nF; C_0603_1608Metric_Pad1.08x0.95mm_HandSolder; LCSC C14663
D2, D3, D4, D5, D6: SS34; D_SMA; Part Number B140-E3/5AT; JLCPCB ID C15759
IC3, IC4, IC5, IC6, IC7: A6214KLKTR-T; SOP100P600X165-11N; Manufacturer_Part_Number A6214KLKTR-T; LCSC C146400
L3, L4, L5, L6, L7: 47 uH 2A; DR125-470-R; LCSC C5127262
R15, R17, R19, R21, R23: 442k; R_0603_1608Metric_Pad0.98x0.95mm_HandSolder; LCSC C23175
R16, R18, R20, R22, R24: R120 or R260; R_2512_6332Metric_Pad1.40x3.35mm_HandSolder

Connections of its further copies:
+12V: C28.2, C29.1, C33.2, C34.1, C38.2, C39.1, C43.2, C44.1, C48.2, C49.1, IC3.1 (VIN), IC4.1 (VIN), IC5.1 (VIN), IC6.1 (VIN), IC7.1 (VIN), R15.2, R17.2, R19.2, R21.2, R23.2; also elsewhere on the board
/I_LED_1: IC5.8 (CSH), L5.2, R20.2; also elsewhere on the board
/I_LED_2: IC3.8 (CSH), L3.2, R16.2; also elsewhere on the board
/I_LED_3: IC6.8 (CSH), L6.2, R22.2; also elsewhere on the board
/I_LED_4: IC4.8 (CSH), L4.2, R18.2; also elsewhere on the board
/I_LED_5: IC7.8 (CSH), L7.2, R24.2; also elsewhere on the board
/LED_1: C42.1, IC5.7 (CSL), R20.1; also elsewhere on the board
/LED_2: C32.1, IC3.7 (CSL), R16.1; also elsewhere on the board
/LED_3: C47.1, IC6.7 (CSL), R22.1; also elsewhere on the board
/LED_4: C37.1, IC4.7 (CSL), R18.1; also elsewhere on the board
/LED_5: C52.1, IC7.7 (CSL), R24.1; also elsewhere on the board
/PWM_1: IC5.3 (EN/PWM); also elsewhere on the board
/PWM_2: IC3.3 (EN/PWM); also elsewhere on the board
/PWM_3: IC6.3 (EN/PWM); also elsewhere on the board
/PWM_4: IC4.3 (EN/PWM); also elsewhere on the board
/PWM_5: IC7.3 (EN/PWM); also elsewhere on the board
GND: C28.1, C29.2, C30.2, C32.2, C33.1, C34.2, C35.2, C37.2, C38.1, C39.2, C40.2, C42.2, C43.1, C44.2, C45.2, C47.2, C48.1, C49.2, C50.2, C52.2, D2.2 (A), D3.2 (A), D4.2 (A), D5.2 (A), D6.2 (A), IC3.6 (GND_1), IC3.11 (GND_2), IC4.6 (GND_1), IC4.11 (GND_2), IC5.6 (GND_1), IC5.11 (GND_2), IC6.6 (GND_1), IC6.11 (GND_2), IC7.6 (GND_1), IC7.11 (GND_2); also elsewhere on the board
unnamed: C31.1, D2.1 (K), IC3.10 (SW), L3.1
unnamed: C36.1, D3.1 (K), IC4.10 (SW), L4.1
unnamed: C41.1, D4.1 (K), IC5.10 (SW), L5.1
unnamed: C46.1, D5.1 (K), IC6.10 (SW), L6.1
unnamed: C51.1, D6.1 (K), IC7.10 (SW), L7.1
unnamed: C30.1, IC3.4 (ADIM), IC3.5 (VCC)
unnamed: C31.2, IC3.9 (BOOT)
unnamed: IC3.2 (TON), R15.1
unnamed: C35.1, IC4.4 (ADIM), IC4.5 (VCC)
unnamed: C36.2, IC4.9 (BOOT)
unnamed: IC4.2 (TON), R17.1
unnamed: C40.1, IC5.4 (ADIM), IC5.5 (VCC)
unnamed: C41.2, IC5.9 (BOOT)
unnamed: IC5.2 (TON), R19.1
unnamed: C45.1, IC6.4 (ADIM), IC6.5 (VCC)
unnamed: C46.2, IC6.9 (BOOT)
unnamed: IC6.2 (TON), R21.1
unnamed: C50.1, IC7.4 (ADIM), IC7.5 (VCC)
unnamed: C51.2, IC7.9 (BOOT)
unnamed: IC7.2 (TON), R23.1

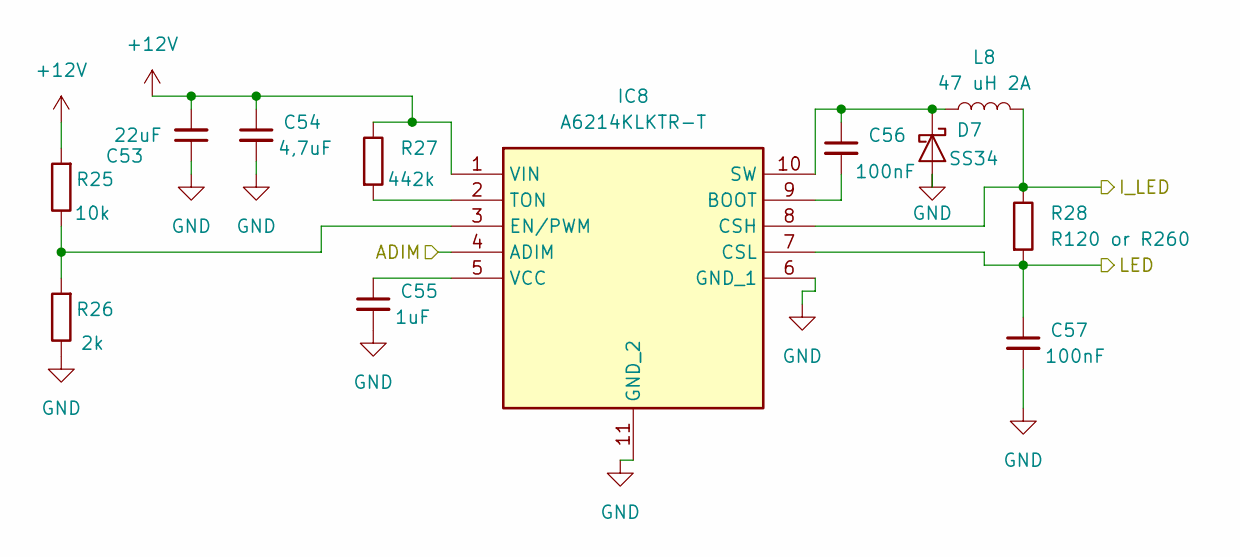
[picture p27: schematic Led_driver_adim.kicad_sch]

Parts:
C53: 22uF; C_0805_2012Metric_Pad1.18x1.45mm_HandSolder; LCSC C96446
C54: 4,7uF; C_0603_1608Metric_Pad1.08x0.95mm_HandSolder; LCSC C19666
C55: 1uF; C_0603_1608Metric_Pad1.08x0.95mm_HandSolder; LCSC C15849
C56, C57: 100nF; C_0603_1608Metric_Pad1.08x0.95mm_HandSolder; LCSC C14663
D7: SS34; D_SMA; Part Number B140-E3/5AT; JLCPCB ID C15759
IC8: A6214KLKTR-T; SOP100P600X165-11N; Manufacturer_Part_Number A6214KLKTR-T; LCSC C146400
L8: 47 uH 2A; DR125-470-R; LCSC C5127262
R25: 10k; R_0603_1608Metric_Pad0.98x0.95mm_HandSolder; LCSC C25804
R26: 2k; R_0603_1608Metric_Pad0.98x0.95mm_HandSolder; LCSC C22975
R27: 442k; R_0603_1608Metric_Pad0.98x0.95mm_HandSolder; LCSC C23175
R28: R120 or R260; R_2512_6332Metric_Pad1.40x3.35mm_HandSolder

Connections:
+12V: C53.2, C54.1, IC8.1 (VIN), R25.1, R27.2; also elsewhere on the board
/ADIM_0: IC8.4 (ADIM); also elsewhere on the board
/I_LED_6: IC8.8 (CSH), L8.2, R28.2; also elsewhere on the board
/LED_6: C57.1, IC8.7 (CSL), R28.1; also elsewhere on the board
GND: C53.1, C54.2, C55.2, C57.2, D7.2 (A), IC8.6 (GND_1), IC8.11 (GND_2), R26.2; also elsewhere on the board
unnamed: C56.1, D7.1 (K), IC8.10 (SW), L8.1
unnamed: C56.2, IC8.9 (BOOT)
unnamed: IC8.3 (EN/PWM), R25.2, R26.1
unnamed: IC8.2 (TON), R27.1
unnamed: C55.1, IC8.5 (VCC)

Parts of its further copies:
C58, C63, C68, C73, C78: 22uF; C_0805_2012Metric_Pad1.18x1.45mm_HandSolder; LCSC C96446
C59, C64, C69, C74, C79: 4,7uF; C_0603_1608Metric_Pad1.08x0.95mm_HandSolder; LCSC C19666
C60, C65, C70, C75, C80: 1uF; C_0603_1608Metric_Pad1.08x0.95mm_HandSolder; LCSC C15849
C61, C62, C66, C67, C71, C72, C76, C77, C81, C82: 100nF; C_0603_1608Metric_Pad1.08x0.95mm_HandSolder; LCSC C14663
D8, D9, D10, D11, D12: SS34; D_SMA; Part Number B140-E3/5AT; JLCPCB ID C15759
IC9, IC10, IC11, IC12, IC13: A6214KLKTR-T; SOP100P600X165-11N; Manufacturer_Part_Number A6214KLKTR-T; LCSC C146400
L9, L10, L11, L12, L13: 47 uH 2A; DR125-470-R; LCSC C5127262
R29, R33, R37, R41, R45: 10k; R_0603_1608Metric_Pad0.98x0.95mm_HandSolder; LCSC C25804
R30, R34, R38, R42, R46: 2k; R_0603_1608Metric_Pad0.98x0.95mm_HandSolder; LCSC C22975
R31, R35, R39, R43, R47: 442k; R_0603_1608Metric_Pad0.98x0.95mm_HandSolder; LCSC C23175
R32, R36, R40, R44, R48: R120 or R260; R_2512_6332Metric_Pad1.40x3.35mm_HandSolder

Connections of its further copies:
+12V: C58.2, C59.1, C63.2, C64.1, C68.2, C69.1, C73.2, C74.1, C78.2, C79.1, IC9.1 (VIN), IC10.1 (VIN), IC11.1 (VIN), IC12.1 (VIN), IC13.1 (VIN), R29.1, R31.2, R33.1, R35.2, R37.1, R39.2, R41.1, R43.2, R45.1, R47.2; also elsewhere on the board
/ADIM_1: IC9.4 (ADIM); also elsewhere on the board
/ADIM_2: IC10.4 (ADIM); also elsewhere on the board
/ADIM_3: IC11.4 (ADIM); also elsewhere on the board
/ADIM_4: IC12.4 (ADIM); also elsewhere on the board
/ADIM_5: IC13.4 (ADIM); also elsewhere on the board
/I_LED_7: IC9.8 (CSH), L9.2, R32.2; also elsewhere on the board
/I_LED_8: IC10.8 (CSH), L10.2, R36.2; also elsewhere on the board
/I_LED_9: IC11.8 (CSH), L11.2, R40.2; also elsewhere on the board
/I_LED_10: IC12.8 (CSH), L12.2, R44.2; also elsewhere on the board
/I_LED_11: IC13.8 (CSH), L13.2, R48.2; also elsewhere on the board
/LED_7: C62.1, IC9.7 (CSL), R32.1; also elsewhere on the board
/LED_8: C67.1, IC10.7 (CSL), R36.1; also elsewhere on the board
/LED_9: C72.1, IC11.7 (CSL), R40.1; also elsewhere on the board
/LED_10: C77.1, IC12.7 (CSL), R44.1; also elsewhere on the board
/LED_11: C82.1, IC13.7 (CSL), R48.1; also elsewhere on the board
GND: C58.1, C59.2, C60.2, C62.2, C63.1, C64.2, C65.2, C67.2, C68.1, C69.2, C70.2, C72.2, C73.1, C74.2, C75.2, C77.2, C78.1, C79.2, C80.2, C82.2, D8.2 (A), D9.2 (A), D10.2 (A), D11.2 (A), D12.2 (A), IC9.6 (GND_1), IC9.11 (GND_2), IC10.6 (GND_1), IC10.11 (GND_2), IC11.6 (GND_1), IC11.11 (GND_2), IC12.6 (GND_1), IC12.11 (GND_2), IC13.6 (GND_1), IC13.11 (GND_2), R30.2, R34.2, R38.2, R42.2, R46.2; also elsewhere on the board
unnamed: C61.1, D8.1 (K), IC9.10 (SW), L9.1
unnamed: C66.1, D9.1 (K), IC10.10 (SW), L10.1
unnamed: C71.1, D10.1 (K), IC11.10 (SW), L11.1
unnamed: C76.1, D11.1 (K), IC12.10 (SW), L12.1
unnamed: C81.1, D12.1 (K), IC13.10 (SW), L13.1
unnamed: C61.2, IC9.9 (BOOT)
unnamed: IC9.3 (EN/PWM), R29.2, R30.1
unnamed: IC9.2 (TON), R31.1
unnamed: C60.1, IC9.5 (VCC)
unnamed: C66.2, IC10.9 (BOOT)
unnamed: IC10.3 (EN/PWM), R33.2, R34.1
unnamed: IC10.2 (TON), R35.1
unnamed: C65.1, IC10.5 (VCC)
unnamed: C71.2, IC11.9 (BOOT)
unnamed: IC11.3 (EN/PWM), R37.2, R38.1
unnamed: IC11.2 (TON), R39.1
unnamed: C70.1, IC11.5 (VCC)
unnamed: C76.2, IC12.9 (BOOT)
unnamed: IC12.3 (EN/PWM), R41.2, R42.1
unnamed: IC12.2 (TON), R43.1
unnamed: C75.1, IC12.5 (VCC)
unnamed: C81.2, IC13.9 (BOOT)
unnamed: IC13.3 (EN/PWM), R45.2, R46.1
unnamed: IC13.2 (TON), R47.1
unnamed: C80.1, IC13.5 (VCC)

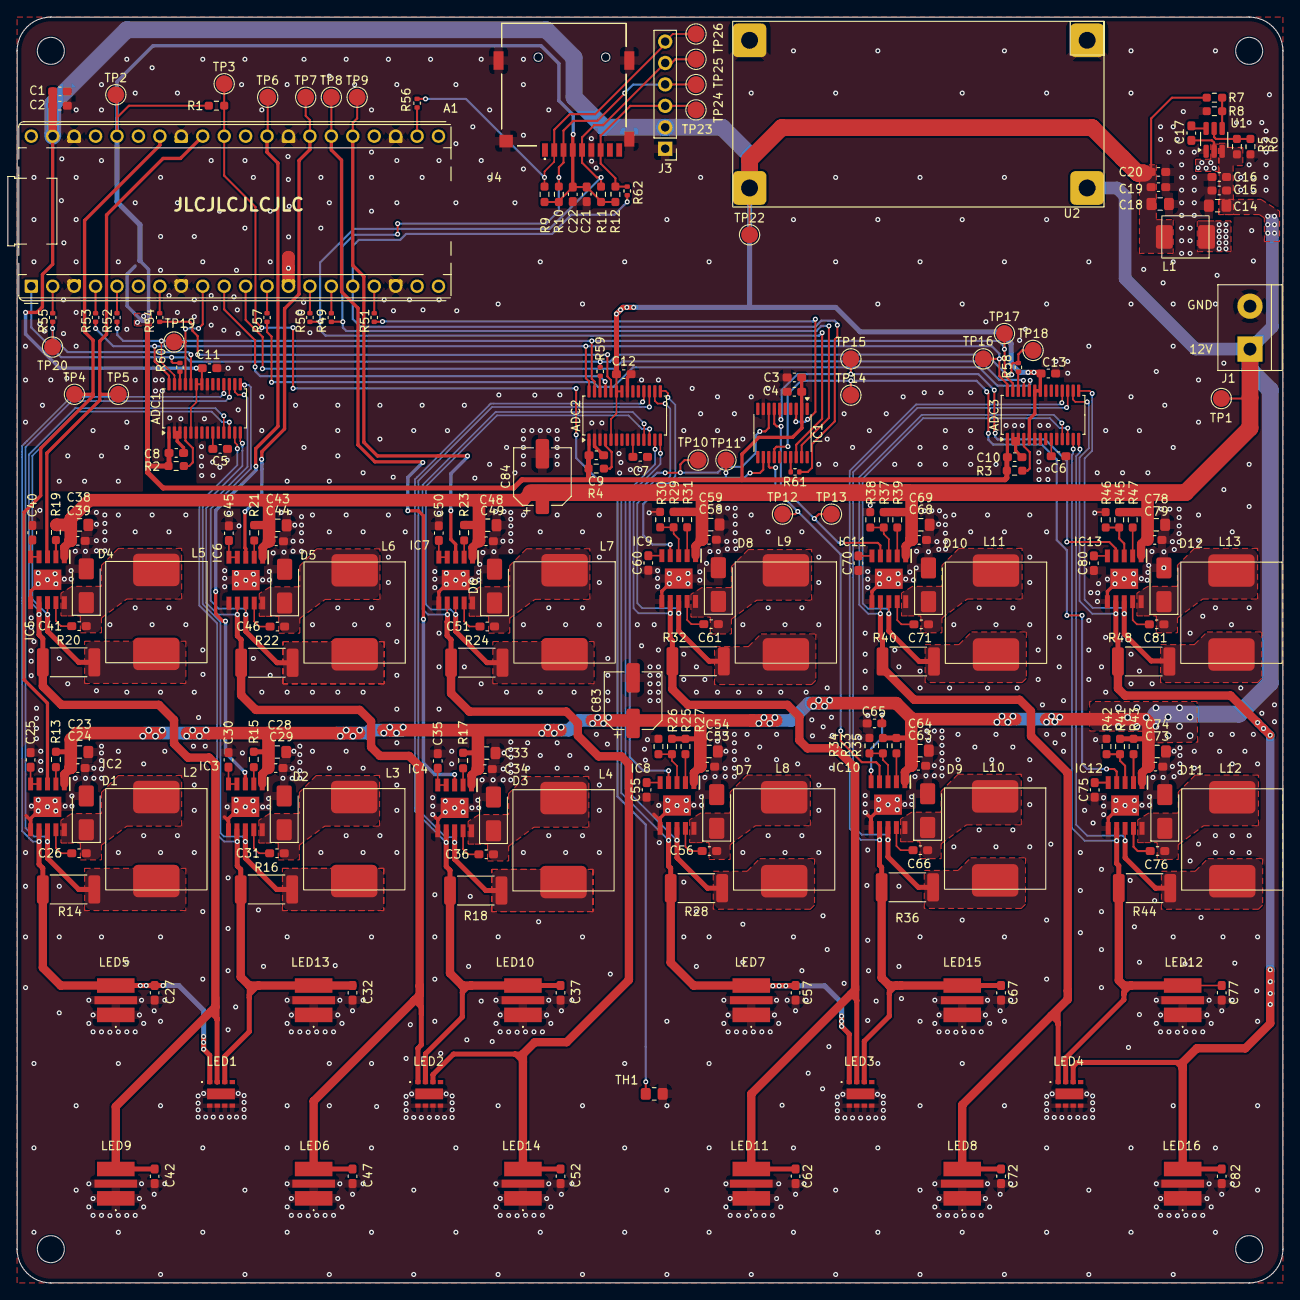
[picture p28: board mgr_board.kicad_pcb from above]

Board: 2 copper layers, 150.0 x 150.0 mm, 239 parts (0 on the bottom side), 133 nets.
