zaku0101/mgr_board/sw/global.h

//data
#define NUM_SPI_ADC_CHANNELS 14
#define MEAS_DATA_BUFF_SIZE 28
#define FILENAME "data.csv"
#define DAC_CHANNELS 6
//uart
#define UART_ID uart0
#define BAUD_RATE 115200
#define UART_TX_PIN 0  
#define UART_RX_PIN 1  

//spi0 pins
#define SPI0_MISO 0
#define SPI0_MOSI 3
#define SPI0_SCK 2

//spi1 pins
#define SPI1_MISO 12
#define SPI1_MOSI 11
#define SPI1_SCK 10

#define ADC0_CS 1
#define ADC1_CS 5
#define DAC_CS 13 
#define SD_CS 17

//adc control pins
#define ADC0_DRDY 6
#define ADC1_DRDY 7
#define ADC1_START 8
#define ADC0_START 9

#define NUMBER_OF_ADC_CHANNELS 7
