zaku0101/mgr_board/sw/hw_config.c

#include <string.h>
#include "my_debug.h"
#include "hw_config.h"
#include "ff.h" /* Obtains integer types */
#include "diskio.h"
#include "hardware/uart.h"
#include "pico/stdlib.h"
#include "global.h"


static spi_t spis[] = {  // One for each SPI.
    {
        .hw_inst = spi1,  // SPI component
        .miso_gpio = SPI1_MISO, // GPIO number (not pin number)
        .mosi_gpio = SPI1_MOSI,
        .sck_gpio = SPI1_SCK,
        .baud_rate = 12500 * 1000,  
        //.baud_rate = 25 * 1000 * 1000, // Actual frequency: 20833333. 
    }
};

// Hardware Configuration of the SD Card "objects"
static sd_card_t sd_cards[] = {  // One for each SD card
    {
        .pcName = "0:",   // Name used to mount device
        .spi = &spis[0],  // Pointer to the SPI driving this card
        .ss_gpio = SD_CS,    // The SPI slave select GPIO for this SD card
        .use_card_detect = false,   // Card detect
        .card_detected_true = -1  // What the GPIO read returns when a card is
                                 // present. Use -1 if there is no card detect.
    }};

/* ********************************************************************** */
size_t sd_get_num() { return count_of(sd_cards); }
sd_card_t *sd_get_by_num(size_t num) {
    if (num <= sd_get_num()) {
        return &sd_cards[num];
    } else {
        return NULL;
    }
}
size_t spi_get_num() { return count_of(spis); }
spi_t *spi_get_by_num(size_t num) {
    if (num <= sd_get_num()) {
        return &spis[num];
    } else {
        return NULL;
    }
}
