zaku0101/mgr_board/(commit log)

2025-02-20 First board schematic version
    [LED_Power_Section_1.kicad_sch, LED_Section.kicad_sch, Led_Power_Section_2.kicad_sch, mgr_board.kicad_sch]
2025-02-23 fixing review suggestions
    [LED_Power_Section_1.kicad_sch, LED_Section.kicad_sch, Led_Power_Section_2.kicad_sch, mgr_board.kicad_sch]
2025-02-23 small changes
    [mgr_board.kicad_sch]
2025-02-27 first complete version schematics
    [LED_Power_Section_1.kicad_sch, Led_Power_Section_2.kicad_sch, mgr_board.kicad_sch]
2025-03-05 Changed footprints of passive elements, reviewed
    [LED_Power_Section_1.kicad_sch, LED_Section.kicad_sch, Led_Power_Section_2.kicad_sch, Micro_SD.kicad_sch, Power_supply.kicad_sch, mgr_board.kicad_sch]
2025-03-06 changing footprint for buck converter coil
    [Power_supply.kicad_sch]
2025-03-09 Commit after kicad fuckup project
    [mgr_board.kicad_pcb]
2025-03-09 drc fixes
    [mgr_board.kicad_pcb]
2025-03-10 finished boarD
    [LED_Section.kicad_sch, Led_driver.kicad_sch, Led_driver_adim.kicad_sch, Micro_SD.kicad_sch, Power_supply.kicad_sch, bom.csv, designators.csv, mgr_board.kicad_pcb]
2025-03-12 adding sw part
    [LED_Power_Section_1.kicad_sch, LED_Section.kicad_sch, Led_Power_Section_2.kicad_sch, Led_driver.kicad_sch, Led_driver_adim.kicad_sch, Micro_SD.kicad_sch, Power_supply.kicad_sch, bom.csv]
2025-03-25 adding DAC driver
2025-03-26 adding ADC driver code defining register and command values for communication, and adding draft of communication functions
2025-03-28 adding functions initalizing and sending commands to adc
2025-03-29 finishing adc handling and adding pwm for diodes
2025-03-31 adding saving data from buffers to sd card csv file and adding interrupt drived ADC measurements as in datasheet
2025-03-31 trying to fix interrupt settings to work
    [ADS1148.c, ADS1148.h, global.h, mgr_board.c]
2025-04-03 fixing bugs not really
    [ADS1148.c, MCP48CV.c, MCP48CV.h, hw_config.c, mgr_board.c, pwm.c, pwm.h, spi_sd_card.c]
2025-04-05 fixing dac and adc communication
    [ADS1148.c, ADS1148.h, MCP48CV.c, MCP48CV.h, global.h, mgr_board.c, pwm.h]
2025-04-14 setting pwm and dac values
2025-04-14 fixing bugs
    [Micro_SD.kicad_sch, Power_supply.kicad_sch, mgr_board.kicad_pcb, positions.csv]
